NiceCircuits/SUPER_UART/front_panel/SUPER UART 2 front panel.pdf

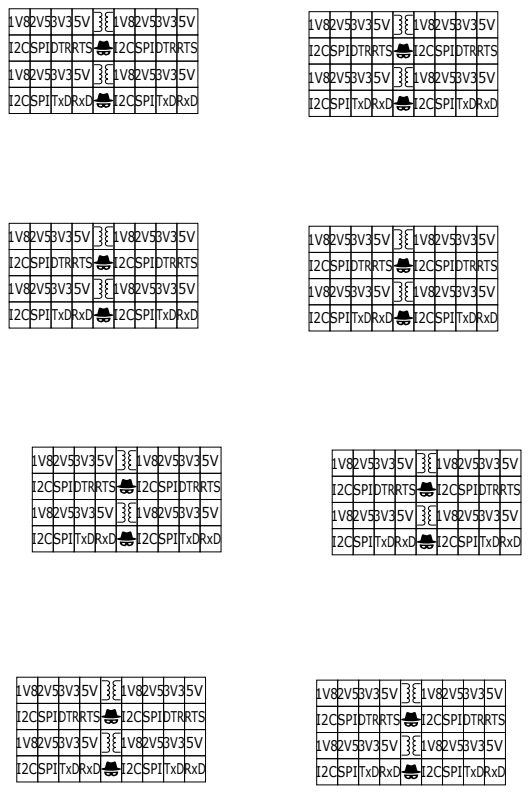
[picture p1: page 1]
1V82V53V35V I2CSPIDTRRTS 1V82V53V35V I2CSPITxDRxD
