NiceCircuits/SUPER_UART/cpld/super_uart.pdf

INV

MPSSE_EN_A | N_MPSSE_EN_A

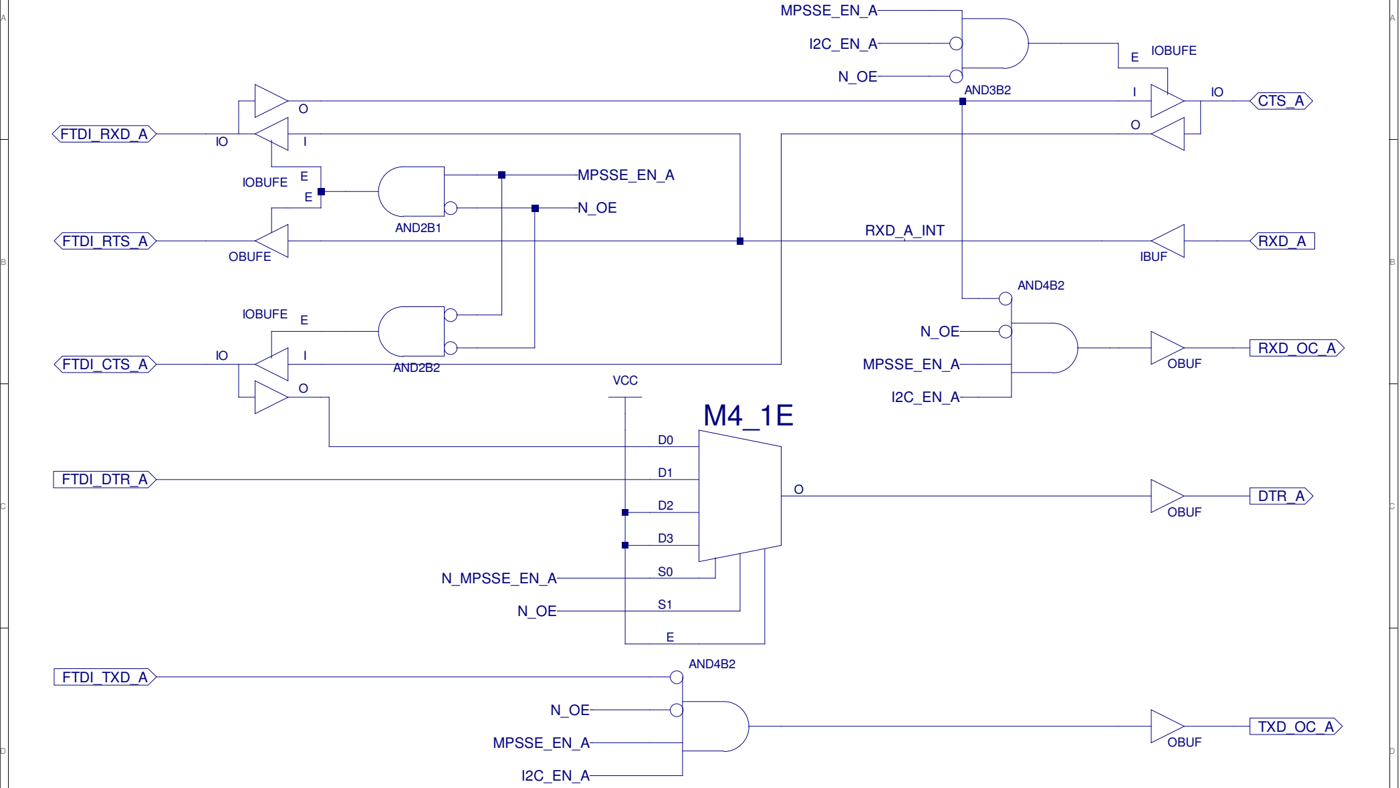
[picture p2: figure]
IOBUFE E; RXD_A_INT; FTDI_RXD_A; AND2B1; MPSSE_EN_A; OBUFE; AND4B2; OBUF; RXD_OC_A; CTS_A; RXD_A; FTDI_DTR_A; FTDI_CTS_A; FTDI_RTS_A; FTDI_TXD_A; TXD_OC_A; N_MPSSE_EN_A; VCC; DTR_A; IBUF; AND3B2; AND2B2

MPSSE_EN_B | N_MPSSE_EN_B
INV

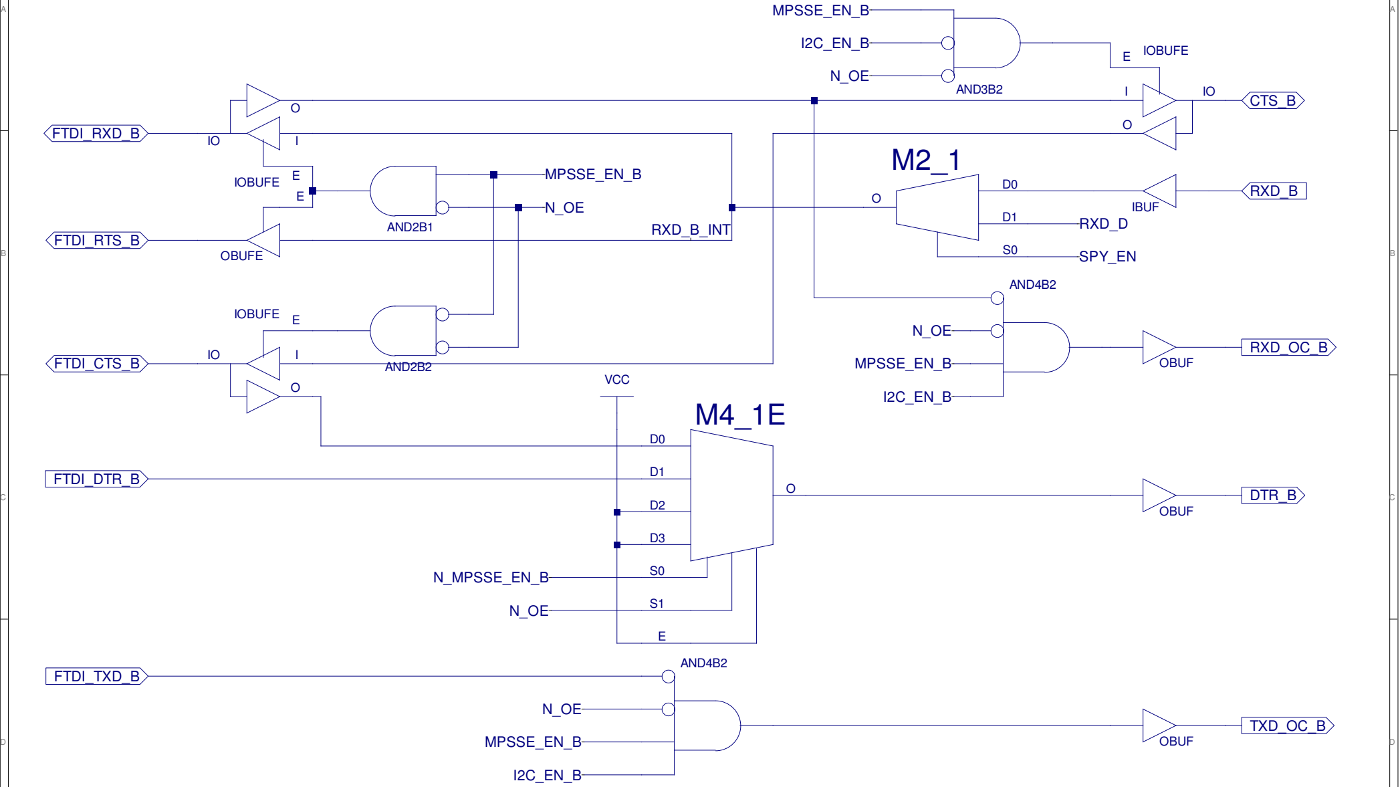
[picture p3: figure]
IOBUFE E; AND2B1; MPSSE_EN_B; OBUFE; AND4B2; OBUF; N_MPSSE_EN_B; VCC; AND3B2; RXD_B_INT; IBUF; RXD_D; SPY_EN; AND2B2; FTDI_RXD_B; RXD_OC_B; CTS_B; FTDI_DTR_B; FTDI_CTS_B; FTDI_RTS_B; FTDI_TXD_B; TXD_OC_B; DTR_B; RXD_B

A | A
B | B

TXD_D_INT

# M4_1E

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
SPY_EN

FTDI_RXD_C
OBUF

N_OE

VCC

RXD_C

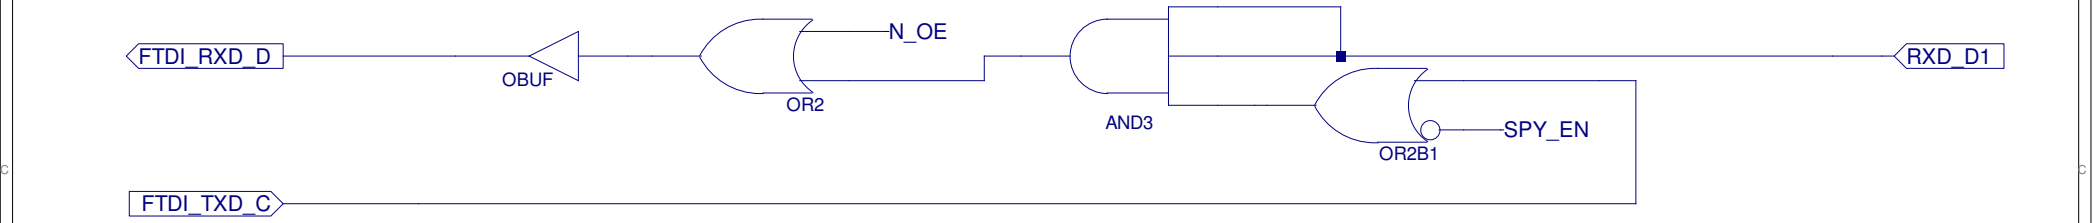
[picture p4: figure]
OBUF; SPY_EN; FTDI_RXD_D; RXD_D1; FTDI_TXD_C; AND3
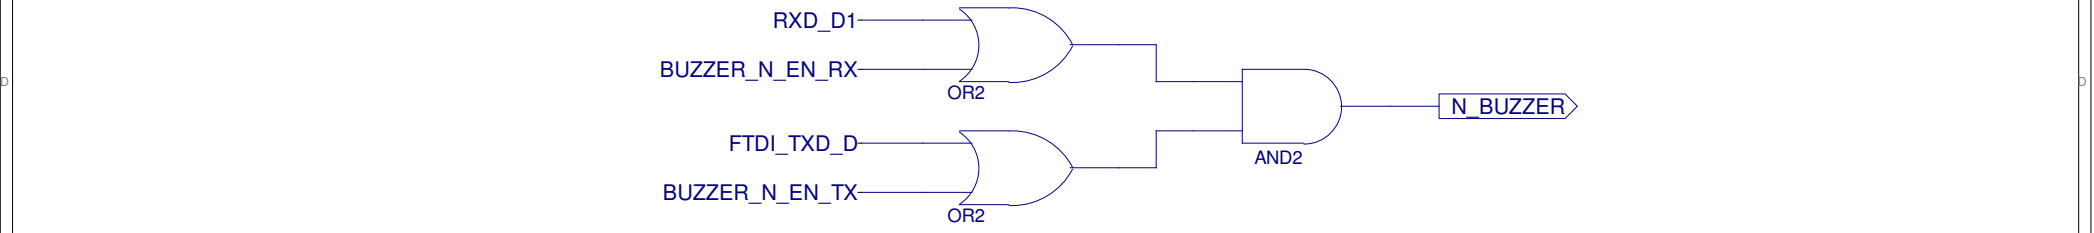
[picture p5: figure]
AND2; BUZZER_N_EN_RX; RXD_D1; FTDI_TXD_D; BUZZER_N_EN_TX; N_BUZZER
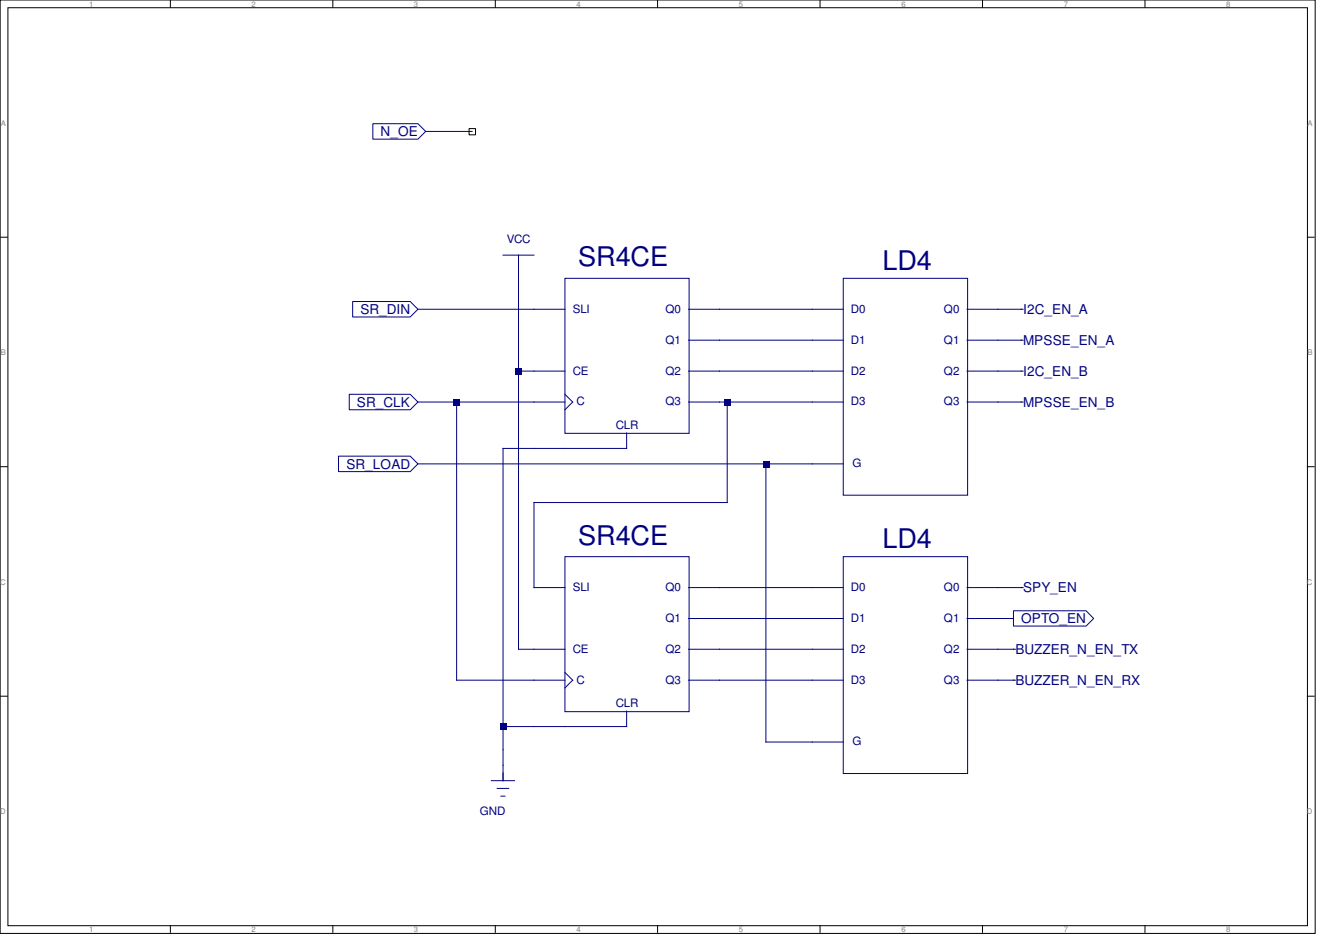
[picture p6: page 4]
