NiceCircuits/SUPER_UART/SUPER_UART_BOM.xlsx

SW | https://www.maritex.com.pl/przelaczniki/przelaczniki_typu_tact_switch/laczniki_tact_switch_5_2x5_2xh_pyloszczelne_smt/tactdf52h16m160-jl.html
93LC46 | farnell
74HC4053D | https://www.maritex.com.pl/polprzewodniki/uklady_logiczne/cmos_serii_74hc/uklady_cmos_serii_74hc_smd/hc4053d.html
FT4232 | alternatywna obudowa? | http://pl.farnell.com/ftdi/ft4232h-56q-reel/interface-bridge-usb-uart-mpsse/dp/2535723
74LVC2T45 | http://pl.farnell.com/nxp/74lvc2t45dc-125/transceiver-bidir-translator-vssop/dp/2444915
 | http://pl.mouser.com/ProductDetail/Nexperia/74LVC2T45DC125/?qs=sGAEpiMZZMutXGli8Ay4kIOzA5y4dyxuGolABzLS2Js%3d
74hc08d | https://www.maritex.com.pl/polprzewodniki/uklady_logiczne/cmos_serii_74hc/uklady_cmos_serii_74hc_smd/hc08d.html
74HC595D | https://www.maritex.com.pl/polprzewodniki/uklady_logiczne/cmos_serii_74hc/uklady_cmos_serii_74hc_smd/hc595d.html
Q 12MHz | https://www.maritex.com.pl/elementy_pasywne/rezonatory_filtry/rezonatory_kwarcowe_smd/rezonatory_kwarcowe_smd_3_2x2_5mm/qsdm12m000-sjk.html
LED R | https://www.maritex.com.pl/led/diody_led_smd/diody_led_0805/diody_led_smd_0805_super-jasne/led0805-s-rw120.html
LED G | https://www.maritex.com.pl/led/diody_led_smd/diody_led_0805/diody_led_smd_0805_super-jasne/led0805-s-gw120.html
inne | https://www.maritex.com.pl/led/diody_led_smd/diody_led_0805/diody_led_smd_0805_super-jasne.html
goldpin | https://www.maritex.com.pl/zlacza/listwy_stykowe_kolkowe/listwy_w_rastrze_2_54mm.html
74LVC8T245PW | Farnell
MIC5504-3.3YM5-TR | Farnell
PDTA143ZT | Farnell
