NiceCircuits/SUPER_UART/doc/SUPER_UART.xlsx

Sheet: Sheet1
 | Pinout
UART | SPI | I2C | FT_UART
RxD |  |  | RxD
TxD | SCK |  | TxD
DTR | MOSI |  | CTS
CTS |  |  | RTS | PINOUT SPI
RTS
 |  |  |  | FTDI PIN | Function | Opto channell | Output pin
 |  |  |  | RxD | MOSI | DTR | RxD
 |  |  |  | TxD | SCK | TxD | TxD
 |  |  |  | CTS | CS | RTS | RTS
 |  |  |  | RTS | MISO | CTS | CTS
 |  |  |  | Pinout I2C
 |  |  |  | FTDI PIN | Function | Opto channell | Output pin
 |  |  |  | RxD | SDA_OUT | DTR | CTS
 |  |  |  | TxD | SCL | TxD | TxD
 |  |  |  | RTS | SDA_IN | CTS | CTS

Sheet: IO
Signal | Port | Direction | Voltage | SPI | Direction | I2C | Direction | SPY 1 | Direction | Direction total | Chip | Additional chip | connection
CTS | A | I | B | MOSI | O | SCL | OC |  |  | I/O/OC | 74LVC1T45 2 | NMOS 3 | CPLD
RxD | A | I | B | MISO | I | SDA | OC |  |  | I/OC | 74LVC1T45 3 | NMOS 4 | CPLD
RxD | C | I | B |  |  |  |  | N.C. | x | I | 74LVC2T45 1 |  | CPLD
CTS | C | I | B |  |  |  |  |  |  | I | 74LVC2T45 1 |  | direct
CTS | B | I | A | MOSI | O | SCL | OC |  |  | I/O/OC | 74LVC1T45 1 | NMOS 1 | CPLD
RxD | B | I | A | MISO | I | SDA | OC | N.C. | x | I/OC | 74LVC8T245 1 | NMOS 2 | CPLD
TxD | B | O | A | SCK | O | N.C. | x | N.C. | x | O | 74LVC8T245 2 |  | CPLD
DTR | B | O | A | CS | O | WP |  |  |  | O | 74LVC8T245 2 |  | direct
DTR | A | O | B | CS | O | WP | O |  |  | O | 74LVC8T245 3 |  | direct
TxD | A | O | B | SCK | O | N.C. | x |  |  | O | 74LVC8T245 3 |  | direct
TxD | C | O | B |  |  |  |  | N.C. | x | O | 74LVC8T245 3 |  | CPLD
DTR | C | O | B |  |  |  |  |  |  | O | 74LVC8T245 3 |  | direct
CTS | D | I | A |  |  |  |  | Master |  | I | 74LVC8T245 1 | RS232 | AND
DCD | D | I | A |  |  |  |  | Master |  | I | 74LVC8T245 1 | RS232 | AND
DSR | D | I | A |  |  |  |  | Master |  | I | 74LVC8T245 1 | RS232 | AND
RI | D | I | A |  |  |  |  | Master |  | I | 74LVC8T245 1 | RS232 | AND
DTR | D | O | A |  |  |  |  | Master |  | O | 74LVC8T245 2 | FORCE | AND
RTS | D | O | A |  |  |  |  | Master |  | O | 74LVC8T245 2 | FORCE | AND
RxD | D | I | A |  |  |  |  | Master |  | I | 74LVC8T245 1 | RS232 | AND, CPLD
TxD | D | O | A |  |  |  |  | Master |  | O | 74LVC8T245 2 | SPY | CPLD
CPLD connections
from FTDI | I2C | to drivers | ext
RxD_D | NMOS 3 | RxD_D | SR_DAT
CTS_A | NMOS 4 | CTS_A | SR_CLK
RxD_A | NMOS 1 | RxD_A | SR_LATCH
CTS_B | NMOS 2 | CTS_B
RxD_B |  | RxD_B
TxD_B
RxD_C |  | RxD_C
TxD_C
TxD_D |  | TxD_D
DTR_D |  | DTR_D
RTS_D |  | RTS_D
RTS_A
RTS_B
TOTAL | 29
MAX | 34
 |  |  | as SR from uC
 |  |  | SPI_EN_A
 |  |  | I2C_EN_A
 |  |  | SPI_EN_B
 |  |  | I2C_EN_B
 |  |  | SPY_EN
 |  |  | DTR_D_FORCE
 |  |  | RTS_D_FORCE

Sheet: Translators
Part | Channels | Direction | Price @10 | Price/ch | Shop
74LV4T125 | 4 | 3.3 -> 1.8..5, separate, OE | 3.34 | 0.835 | only Mouser
74LV1T34 | 1 | 3.3 -> 1.8..5 | 1.11 | 1.11 | Farnell etc.
74LV1T125/126 | 1 | 3.3 -> 1.8..5, OE | 1.11 | 1.11 | Farnell etc.
74LVC1T45 | 1 | * -> *, DIR | 0.76 | 0.76 | TME etc.
74LVC2T45 | 2 | * -> *, DIR | 1.36 | 0.68 | TME etc.
74LVC8T245 | 8 | * -> *, DIR, OE | 3.23 | 0.40375 | TME etc.
74LV1T00/02/04/08/32/86 | 1 | 3.3 -> 1.8..5, logic gate

Sheet: Regulator
Regulated voltage regulator
LP2951CD parameters
Reference Voltage | 1.235 | V
Min. output current | 1 | uA
Feedback Pin Bias Current max. | 40 | nA
Desired output voltages
V1 | 5 | V
V2 | 3.3 | V
V3 | 2.7 | V
V4 | 1.8 | V
Regulator variant 1
R36 for minimum output current | 1.235 | MΩ
R36 selected | 10 | kΩ
R30 calculated | 4.574898785 | kΩ
R30 selected | 4.7 | kΩ
Ifb error max | 0.188 | mV
R35 || R36 calculated | 1.541699867 | kΩ
R35 calculated | 1.822706505 | kΩ
R35 selected | 1.8 | kΩ
R32 || R36 calculated | 2.810895884 | kΩ
R32 calculated | 3.909939039 | kΩ
R32 selected | 3.9 | kΩ
R31 || R36 calculated | 3.962116041 | kΩ
R31 calculated | 6.56209372 | kΩ
R31 selected | 6.8 | kΩ
Output voltages
V1 | 5.040172222 | V
V2 | 3.303783333 | V
V3 | 2.669052941 | V
V4 | 1.81545 | V
Regulator variant 2
Vfb=(Vdd2/R30+Vdd2_sel/Rchain)*(R30||R36||Rchain)
Known points
Vdd2_sel | Vdd2
0 | 5 | V
3.3 | 1.8 | V
R30 selected | 100 | kΩ
Vfb | 1.235 | V
Vfb=5/R30*(R30||R36||Rchain)
Vfb=(1,8/R30+3,3/Rchain)*(R30||R36||Rchain)
(R30||R36||Rchain)=Vfb/5*R30= | 24.7 | kΩ
(1,8/R30+3,3/Rchain)=Vfb/(R30||R36||Rchain)
3,3/Rchain=Vfb/(R30||R36||Rchain)-1,8/R30
Rchain=3,3/(Vfb/(R30||R36||Rchain)-1,8/R30)
Rchain= | 103.125 | kΩ
R36= | 48.10268516 | kΩ
Ifb error max | 4 | mV
R36 selected | 47 | kΩ
R33 selected | 5.6 | kΩ
R34 selected | 47 | kΩ
R31 selected | 47 | kΩ
Rchain total | 99.6 | kΩ
Vdd2/R30+Vdd2_sel/Rchain=Vfb/(R30||R36||Rchain)
Vdd2=(Vfb/(R30||R36||Rchain)-Vdd2_sel/Rchain)*R30
Output voltages
V1 | 5.102619414 | V
V4 | 1.789366402 | V

Sheet: LED
LEDs in project: |  |  | driver resistance
RX/TX buzzer | red | uC | 50
ENABLE A/B/C/D | green | uC | 50
voltage select | green | uC | 50
I2C/SPI/SPY/ISO EN | green | uC | 50
DTR/RTS force | blue | SW | 0
RX/TX | white | 74HC595 | 30
control pins1 | white | 74AC08 | 30
control pins2 | white | 74LVC8T245 | 25
control pins3 | white | FTDI | 15
control pins4 | white | CPLD
LED types | color | intens. @20mA [mcd] | Vdrop @20mA [V] | Vdrop @1mA [V]
HL-PSC-2012U36FC | red | 600 | 2.1 | 1.7
PSC-2012H203BC | blue | 250 | 3.1 | 2.7
HL-PSC-2012U51GC | green | 900 | 3.1 | 2.7
PSC-2012H256W | white | 1200 | 3.1 | 2.7
Desired intensity [mcd] | 35
for white and blue LEDs
 | color | desired current [mA] | desired resistance total | driver resistance | desired resistance | selected
 | blue | 2.80 | 214.2857143 | 0 | 214.2857143 | 220
 | white | 0.58 | 1028.571429 | 30 | 998.5714286 | 1000
for red and green LEDs, multiplexed 1/4
 | color | desired current [mA] | desired resistance total | driver resistance | desired resistance | selected
 | red | 4.67 | 342.8571429 | 50 | 292.8571429 | 220
 | green | 3.11 | 192.8571429 | 50 | 142.8571429 | 220
