NiceCircuits/SUPER_UART/kicad/front/SUPER_UART_Front_Case.stp

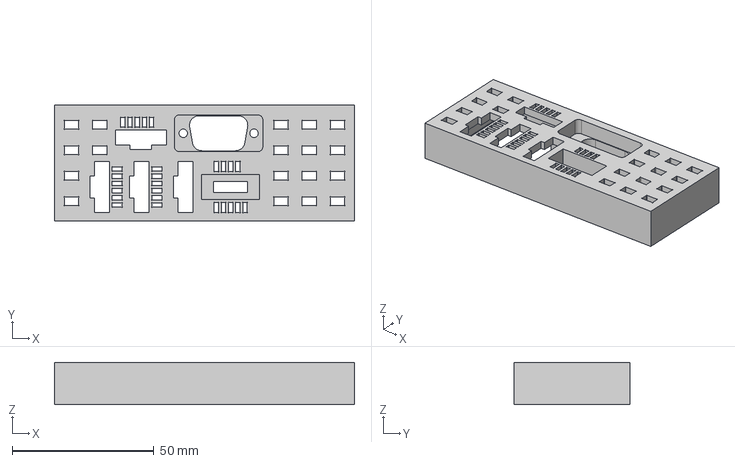
[picture p7: CAD file, 2017-05-09]
kicad/front/SUPER_UART_Front_Case.stp
106.0 x 41.0 x 15.0 mm
