NiceCircuits/SUPER_UART/(list of files, cad)

Other CAD files:
kicad/front/SUPER_UART_Front_Case.dxf
