NiceCircuits/SUPER_UART/kicad/front/SUPER_UART_front.pdf

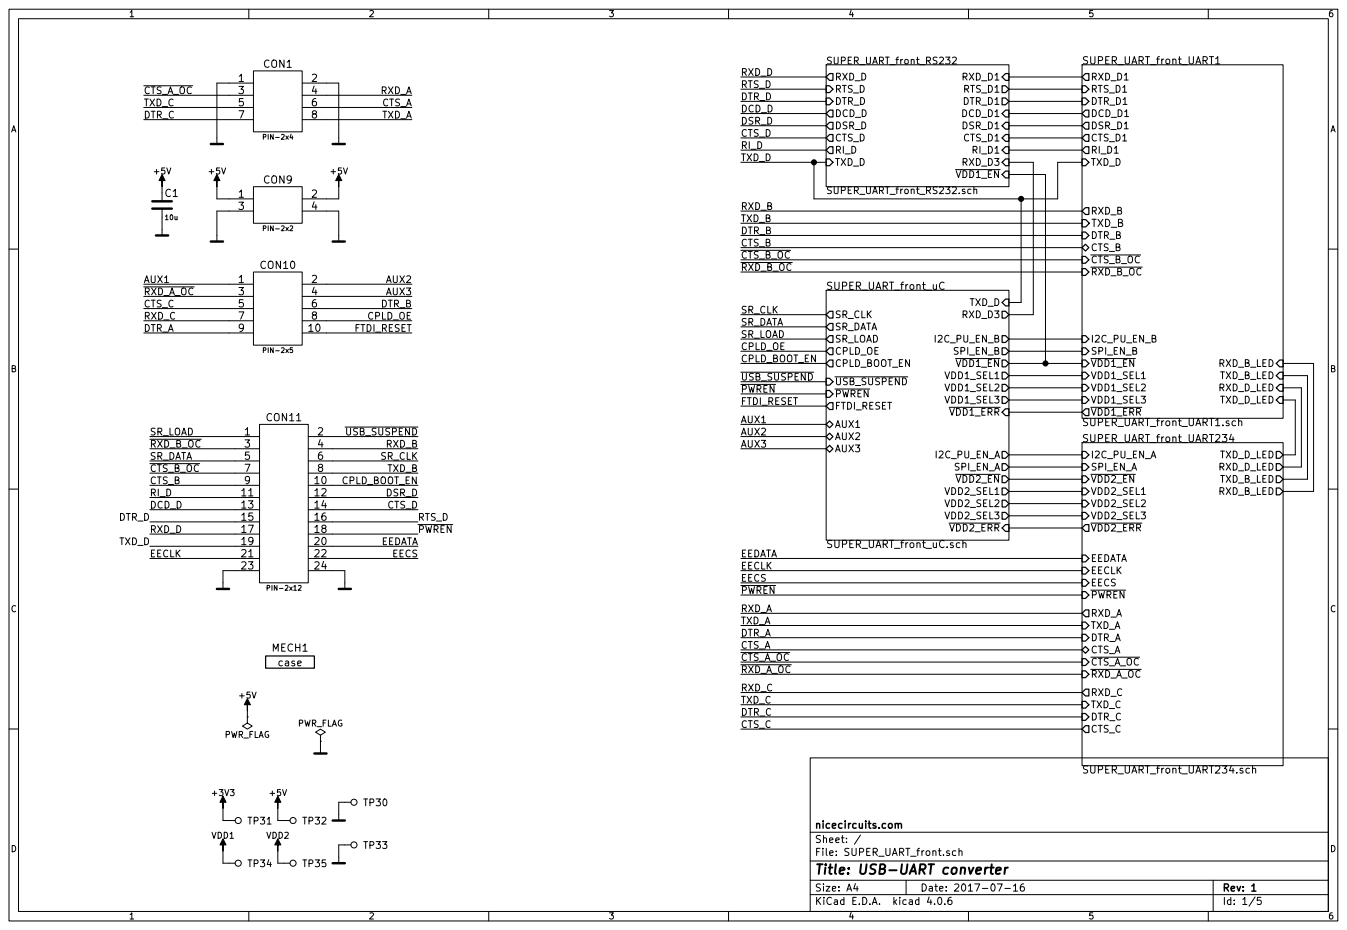
[picture p8: page 1]

CPLD_OE
FTDI_RESET

EECLK | 21 | 22 | EECS

File: SUPER_UART_front.sch Sheet: / nicecircuits.com

Id: 1/5 Title: USB-UART converter

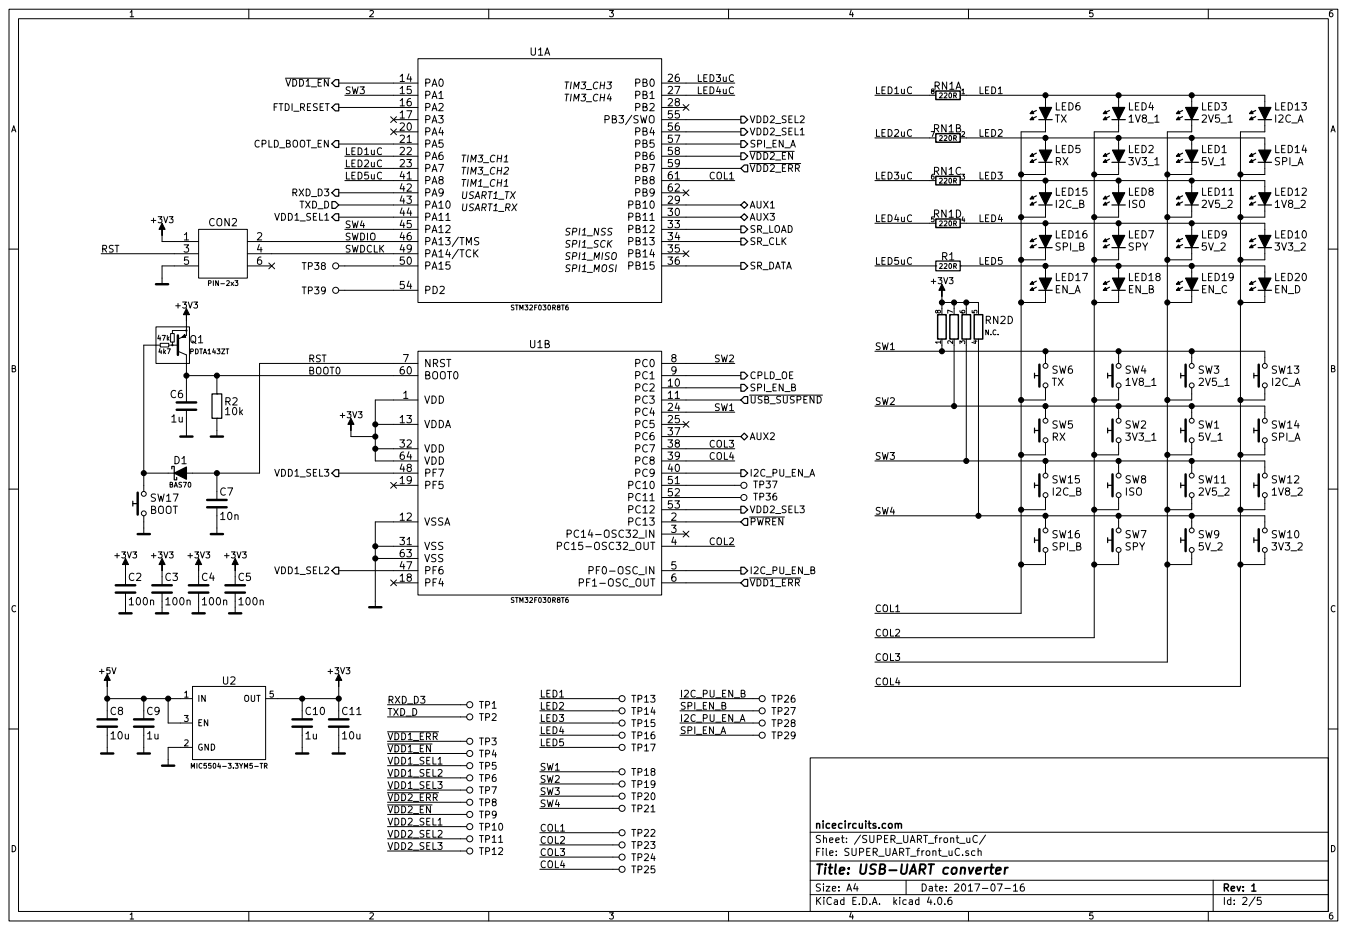
[picture p9: page 2]

File: SUPER_UART_front_uC.sch
Id: 2/5 Title: USB-UART converter

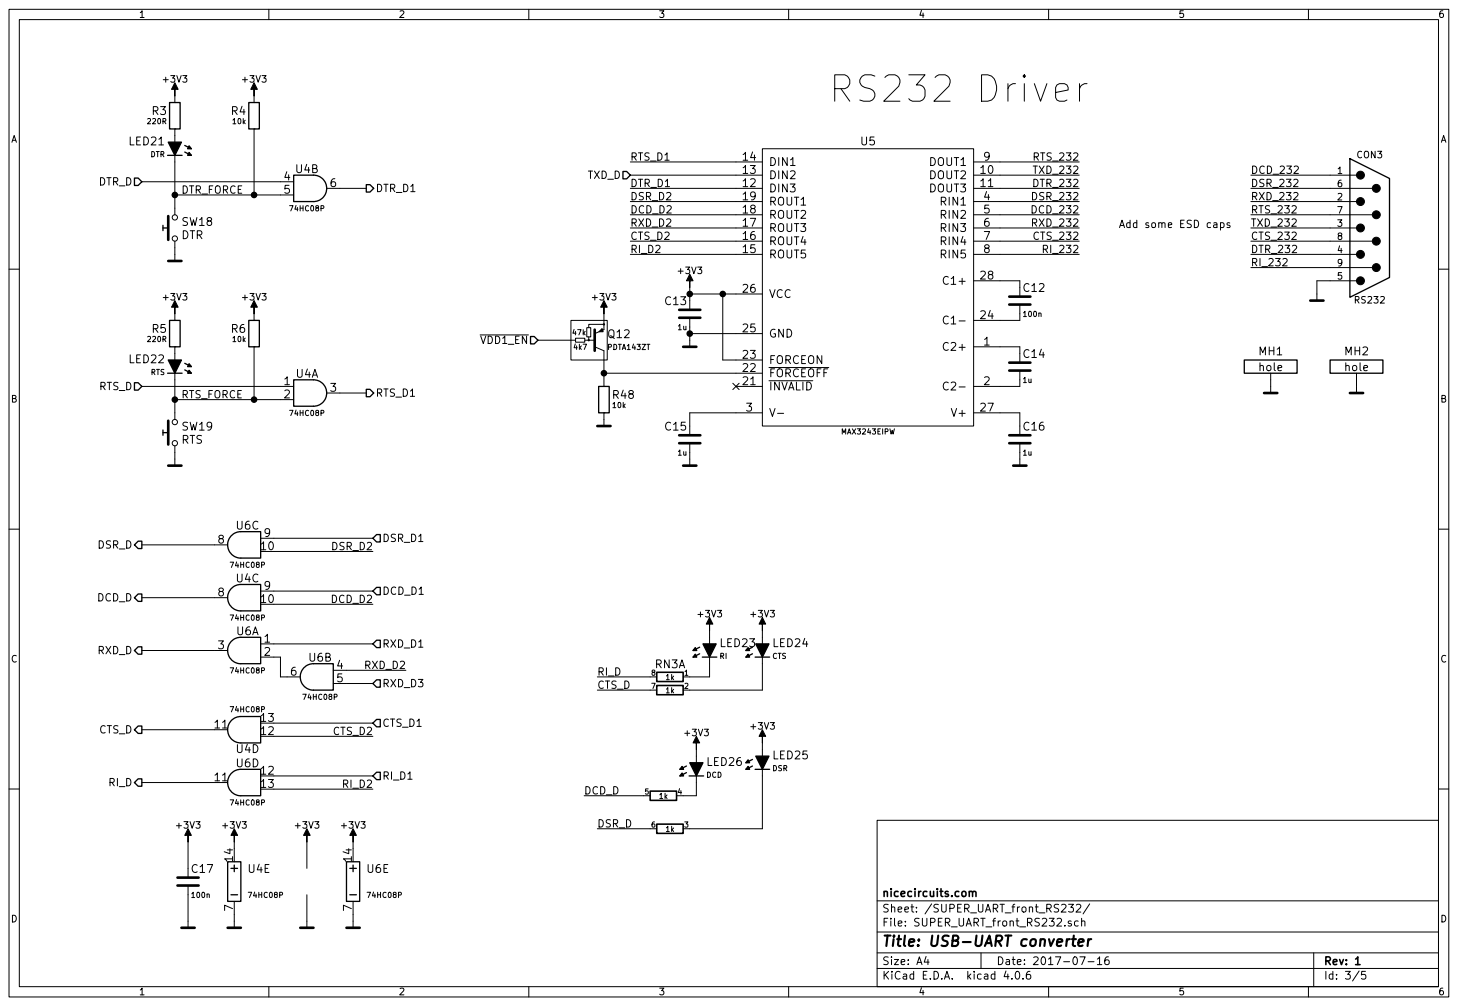
[picture p10: page 3]

Add some ESD caps

File: SUPER_UART_front_RS232.sch
Id: 3/5 Title: USB-UART converter

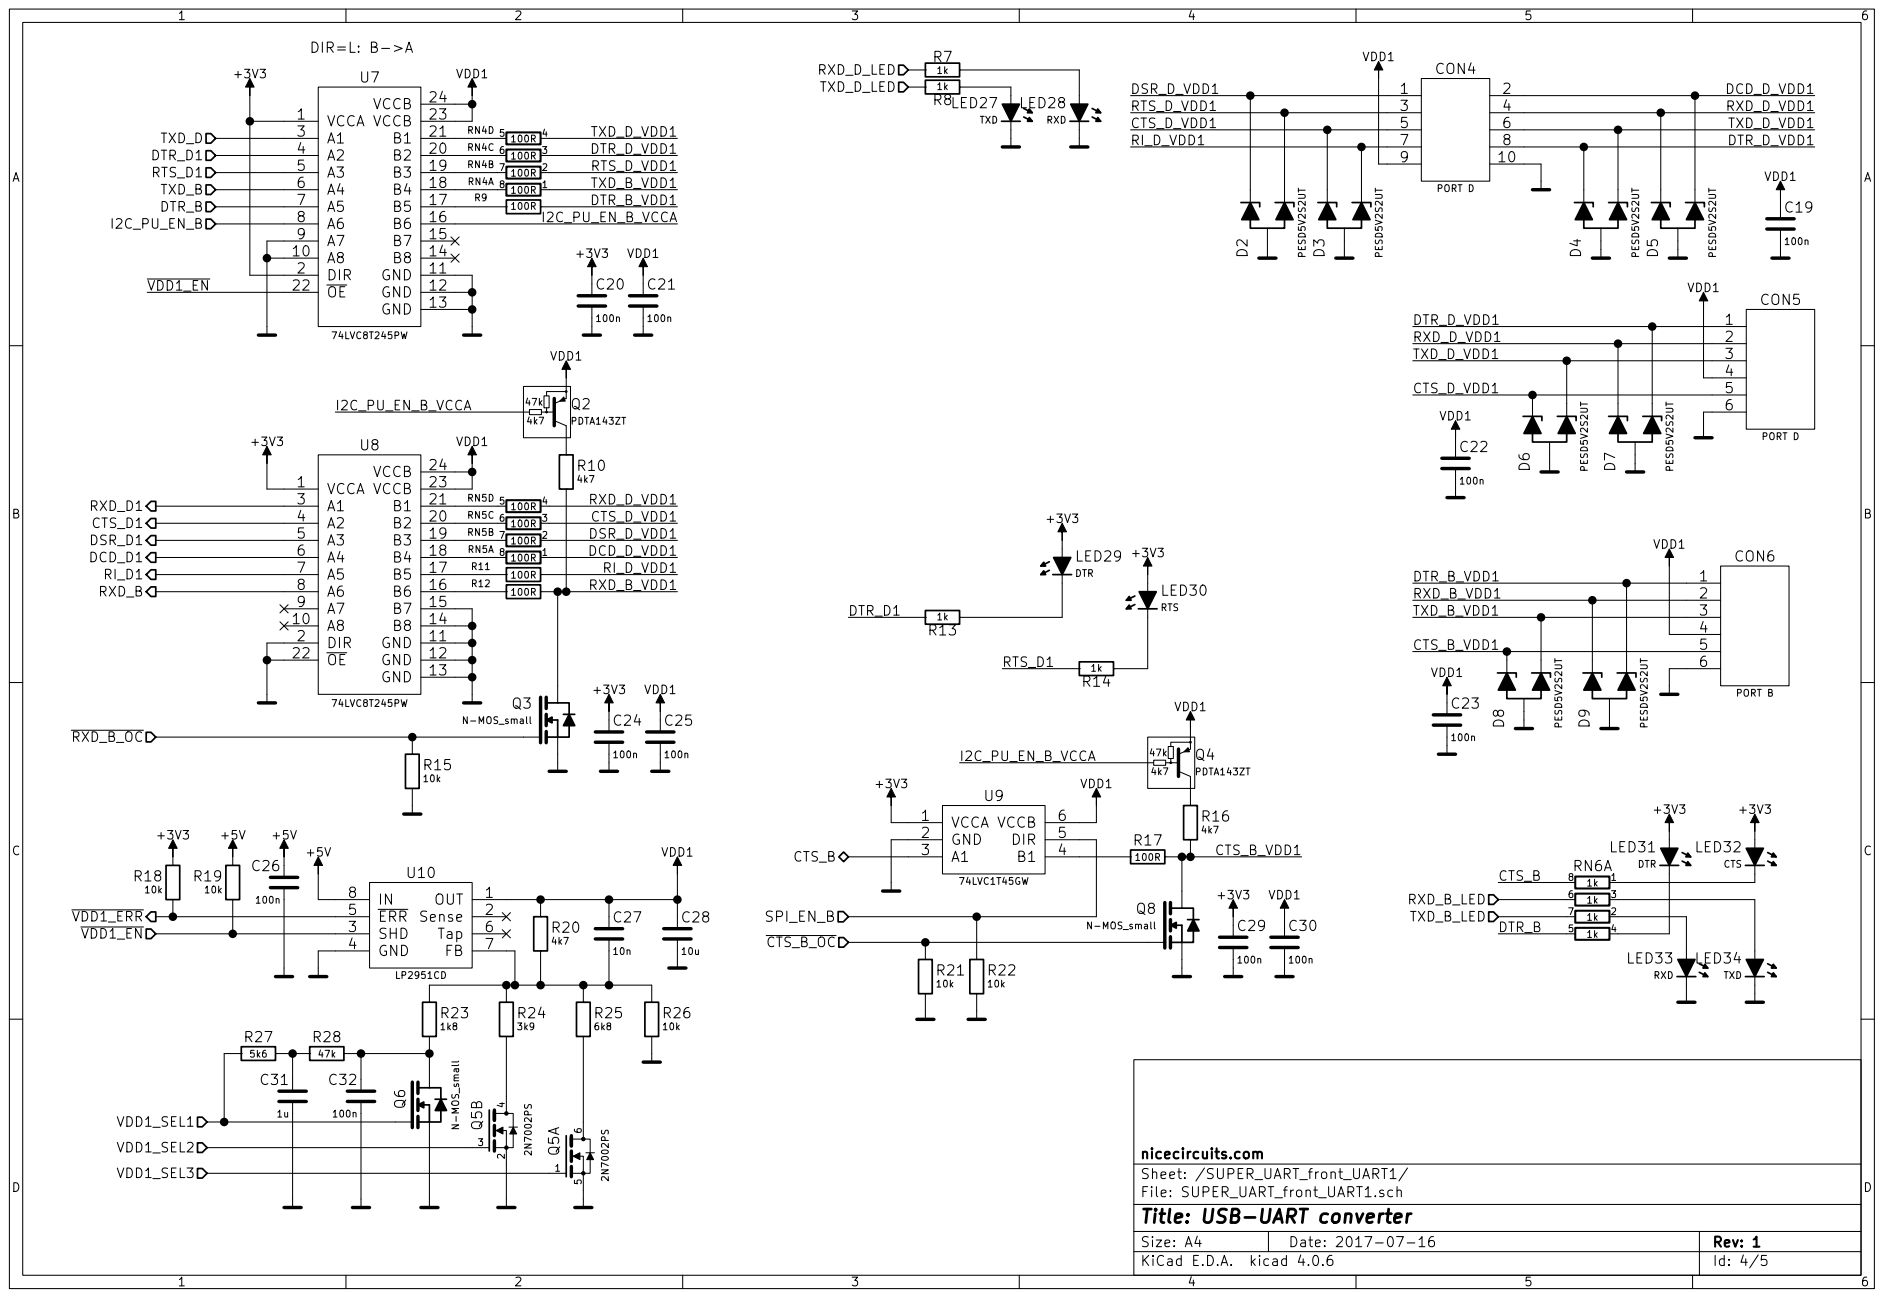
[picture p11: page 4]

TXD_D_VDD1 | 3

TXD_B_VDD1 | 3

File: SUPER_UART_front_UART1.sch
Id: 4/5 Title: USB-UART converter

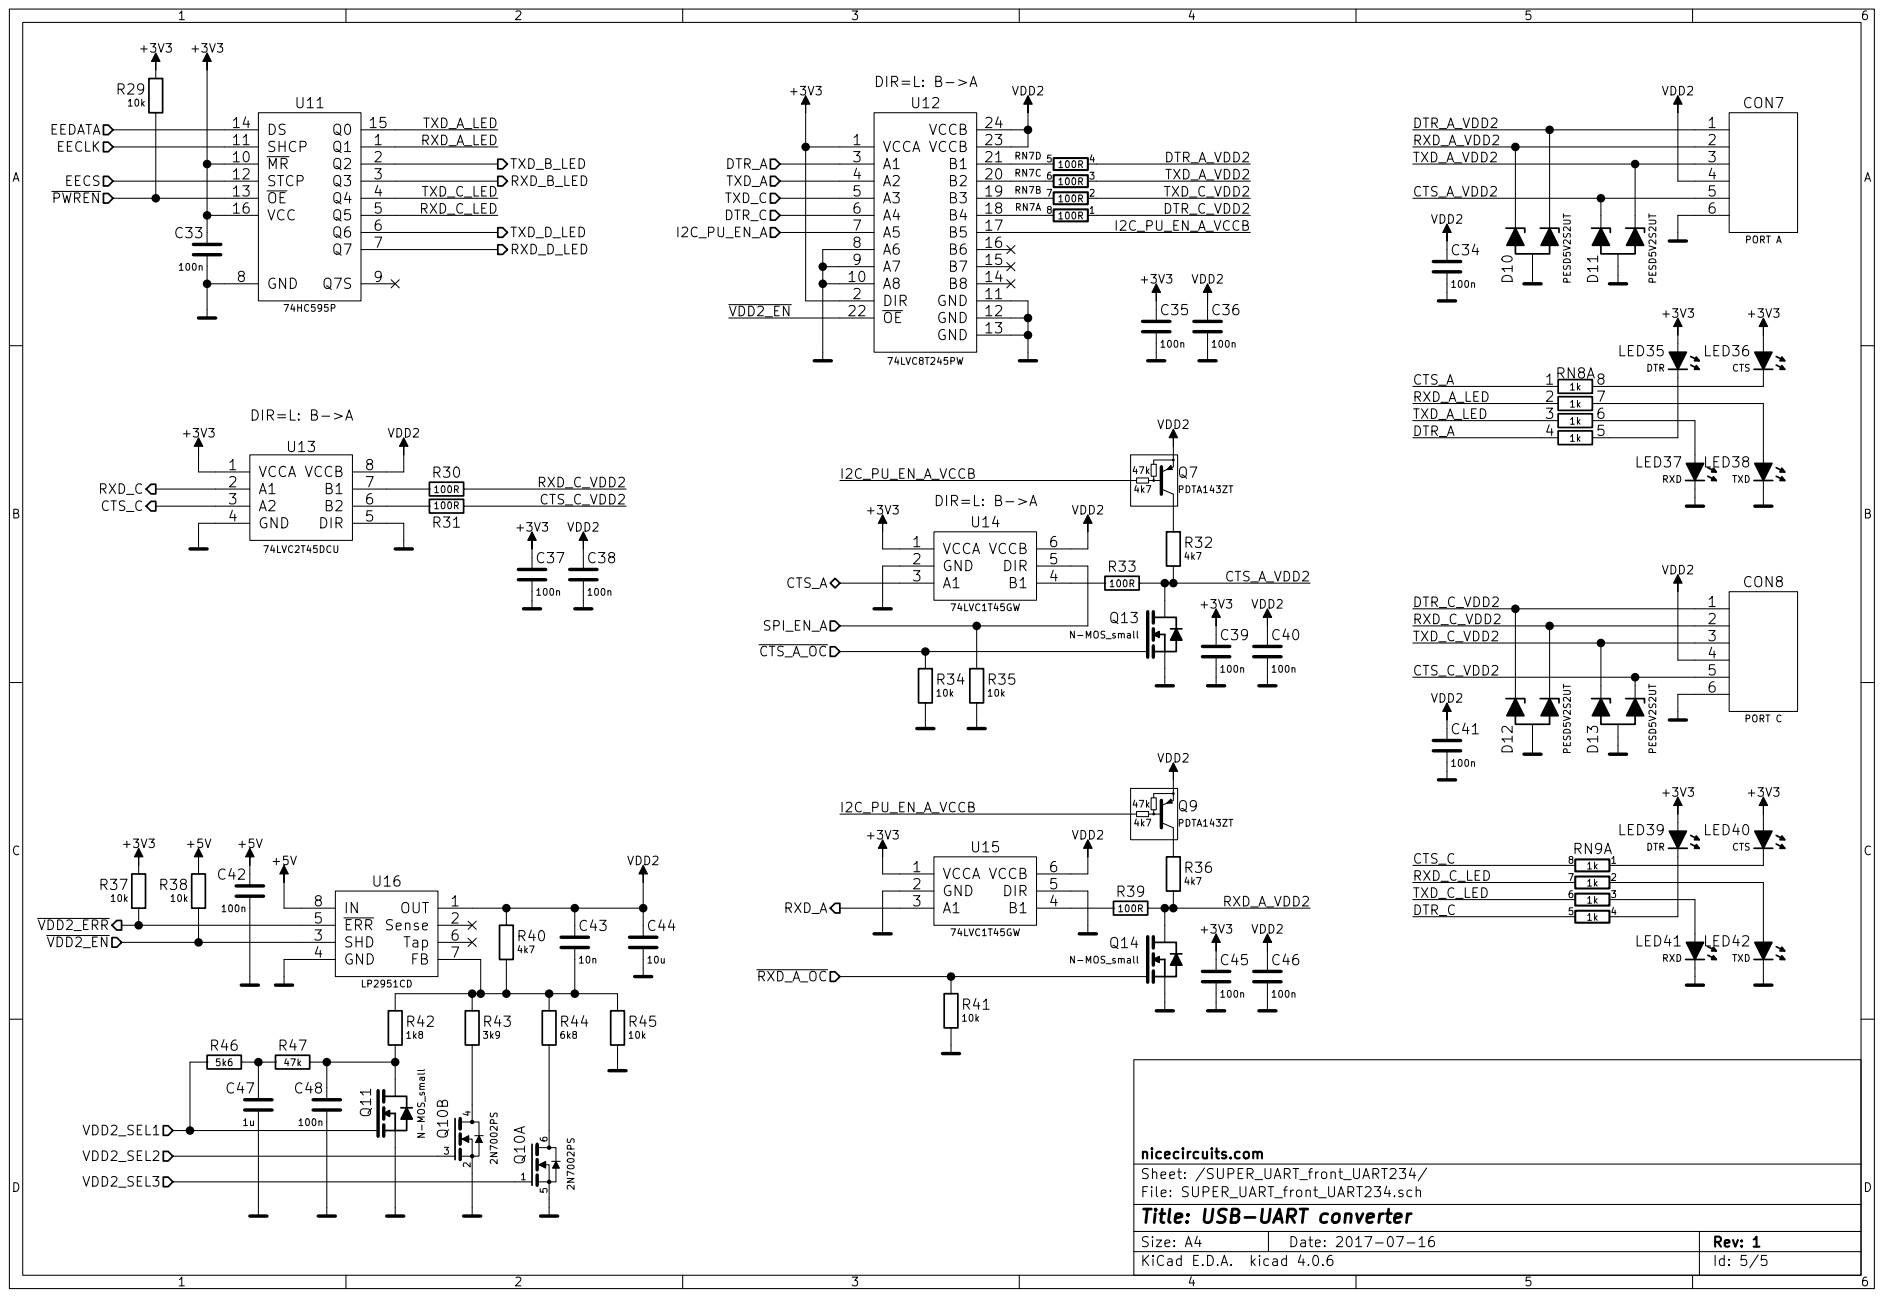
[picture p12: page 5]

TXD_C_VDD2 | 3

File: SUPER_UART_front_UART234.sch
Id: 5/5 Title: USB-UART converter
