NiceCircuits/SUPER_UART/kicad/main/SUPER_UART_main.pdf

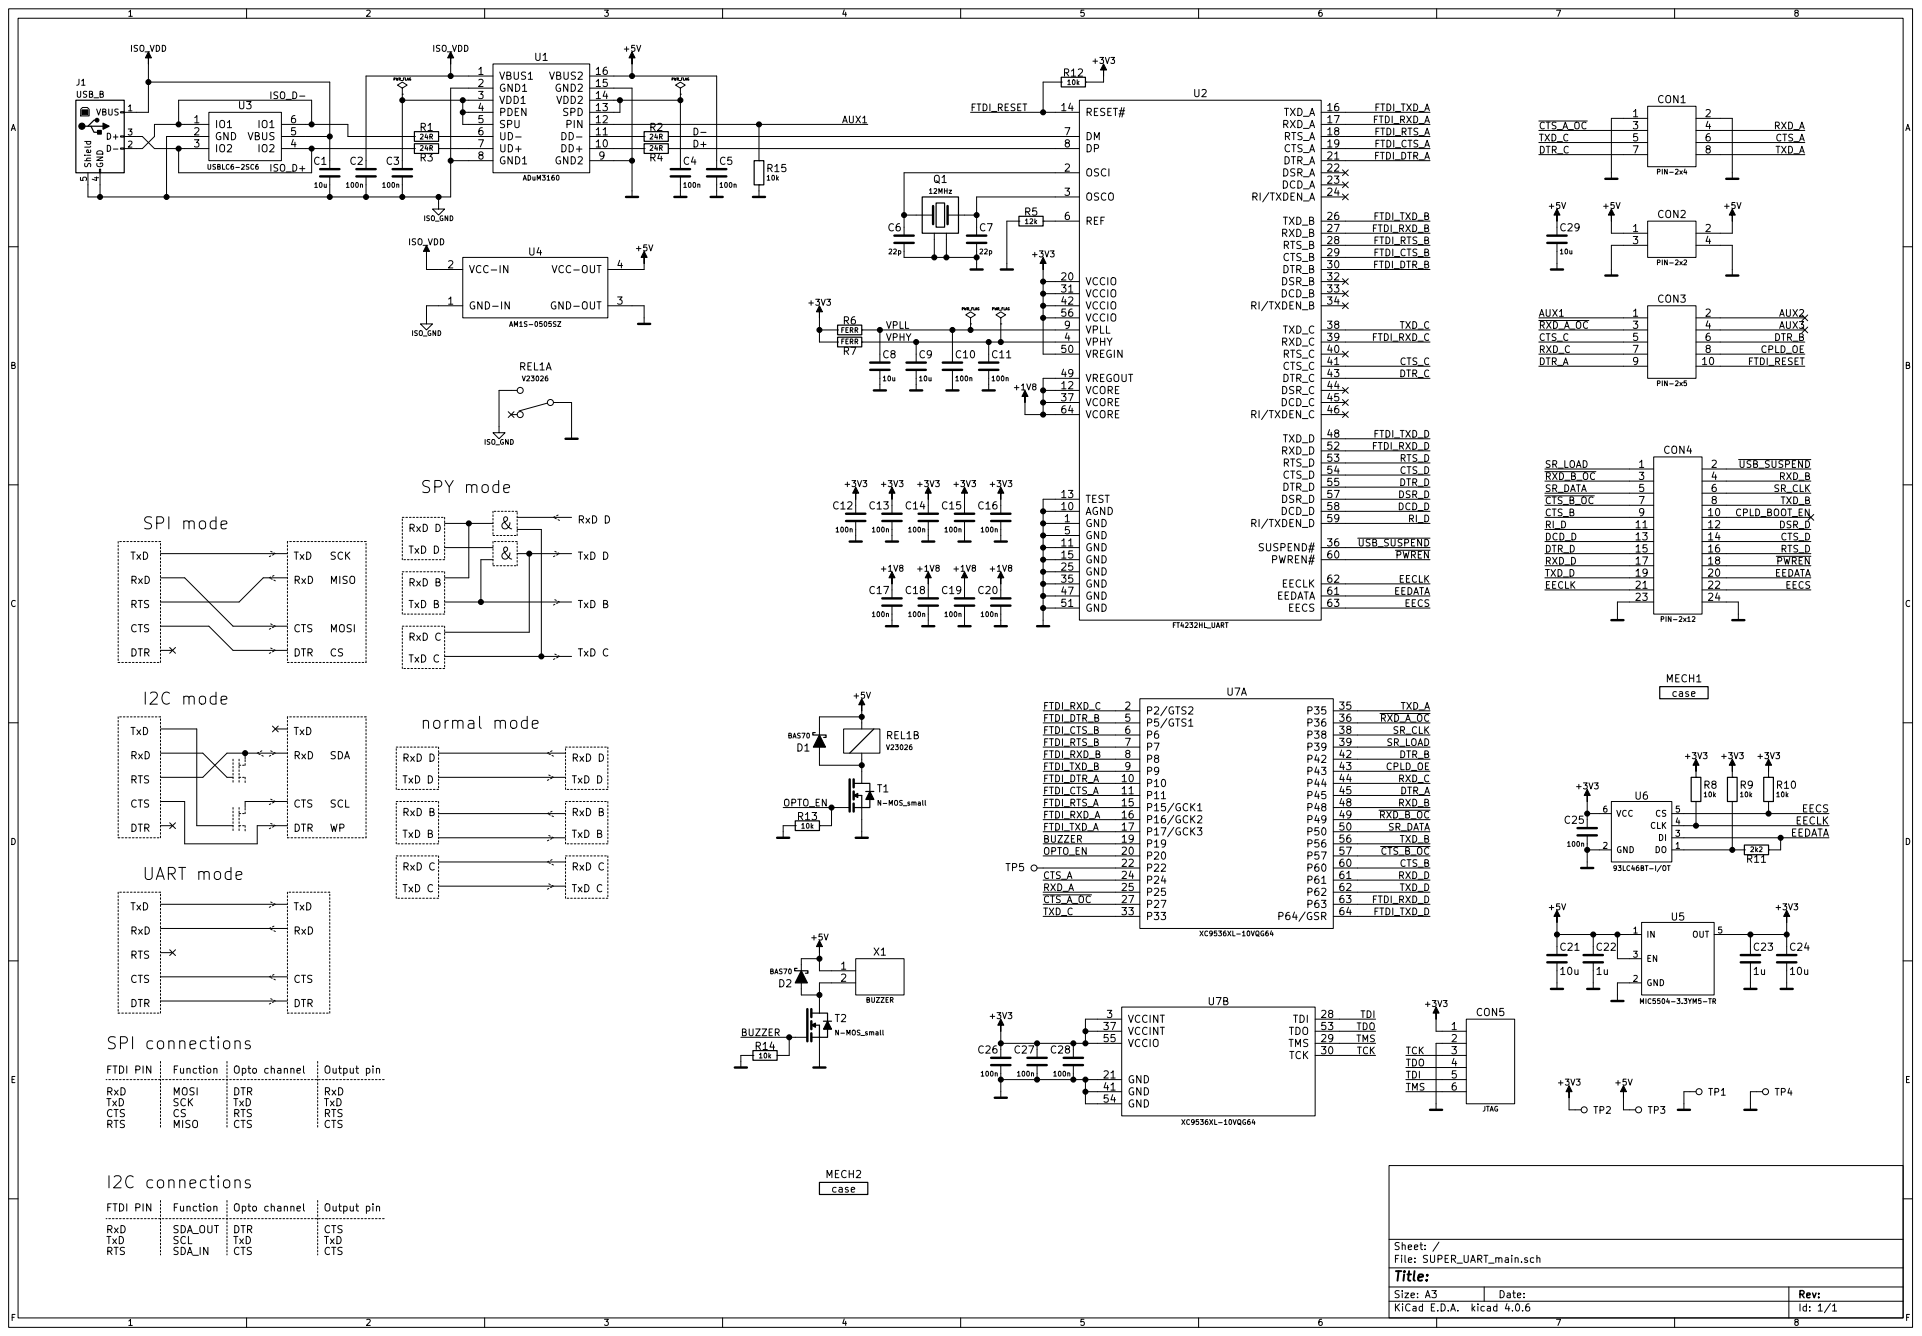
[picture p13: page 1]

FTDI_RTS_B
FTDI_CTS_B

TXD_D | | 20

FTDI_DTR_B

FTDI_TXD_B | CPLD_OE
FTDI_DTR_A
FTDI_CTS_A | DTR_A
FTDI_RTS_A

TDI TDO | 4

TMS
