NiceCircuits/SUPER_UART/img/regulator_northon.asc

R30: res
R30: res
R36: res
R36: res
Rchain: res
Rchain: res
Vdd2/R30: current
Vdd2: voltage
Vdd2_sel/Rchain: current
Vdd2_sel: voltage
Named nets: 0, Vfb
