NiceCircuits/SUPER_UART/sim/LDO.asc

C1: cap; 10µ
C2: cap; 10n
C3: cap; 1µ
C4: cap; 100n
R1: res; 100k
R2: res; 47k
R3: res; 10k
R4: res; 5k6
R5: res; 47k
R6: res; 47k
U1: LP2951
V1: voltage; 5.5
V2: voltage; PULSE(0 3.3 0 1)
Named nets: 0, out, Vin
.tran 2
.meas TRAN duty50 FIND V(Vin)/3.3 WHEN V(out)=5.0
.meas TRAN duty33 FIND V(Vin)/3.3 WHEN V(out)=3.3
.meas TRAN duty25 FIND V(Vin)/3.3 WHEN V(out)=2.5
.meas TRAN duty18 FIND V(Vin)/3.3 WHEN V(out)=1.8
