NiceCircuits/SUPER_UART/sim/STM32_boot_button.asc

C1: cap; 10n
C2: cap; 1µ
D1: schottky; RB521SM-30
M1: nmos; 2N7002
Q1: pnp; BC557B
R1: res; 700k
R2: res; 300k
R3: res; 555k
R4: res; 445k
R5: res; 10k
R6: res; 55k
R7: res; 10k
R8: res; 10k
R9: res; 700k
R10: res; 300k
R11: res; 800k
R12: res; 200k
V1: voltage; 3V3
V2: voltage; 0.07
V3: voltage; 0.398
V4: voltage; PULSE(0 12 100m 1u 1u 100m 100)
V5: voltage; -0.3
V6: voltage; 0.95
X1: comparator; Vhigh=3.3
X2: comparator; Vhigh=3.3
X3: comparator; Vhigh=3.3
X4: comparator; Vhigh=3.3
Named nets: 0, VCC, RST_ACT, RST, RST_NACT, BOOT0, BOOT0_ACT, BOOT0_NACT
.tran 1
