NiceCircuits/SUPER_UART/sim/comparator.asc

B1: bv; V=if(V(IN+)>V(IN-),Vhigh,Vlow)
Named nets: IN+, IN-, OUT+, OUT-
.param Vhigh=1 Vlow=0
