NiceCircuits/SUPER_UART/kicad/front/SUPER_UART_front.kicad_pcb

## KiCad design kicad/front/SUPER_UART_front.kicad_pcb (2020-11-18)

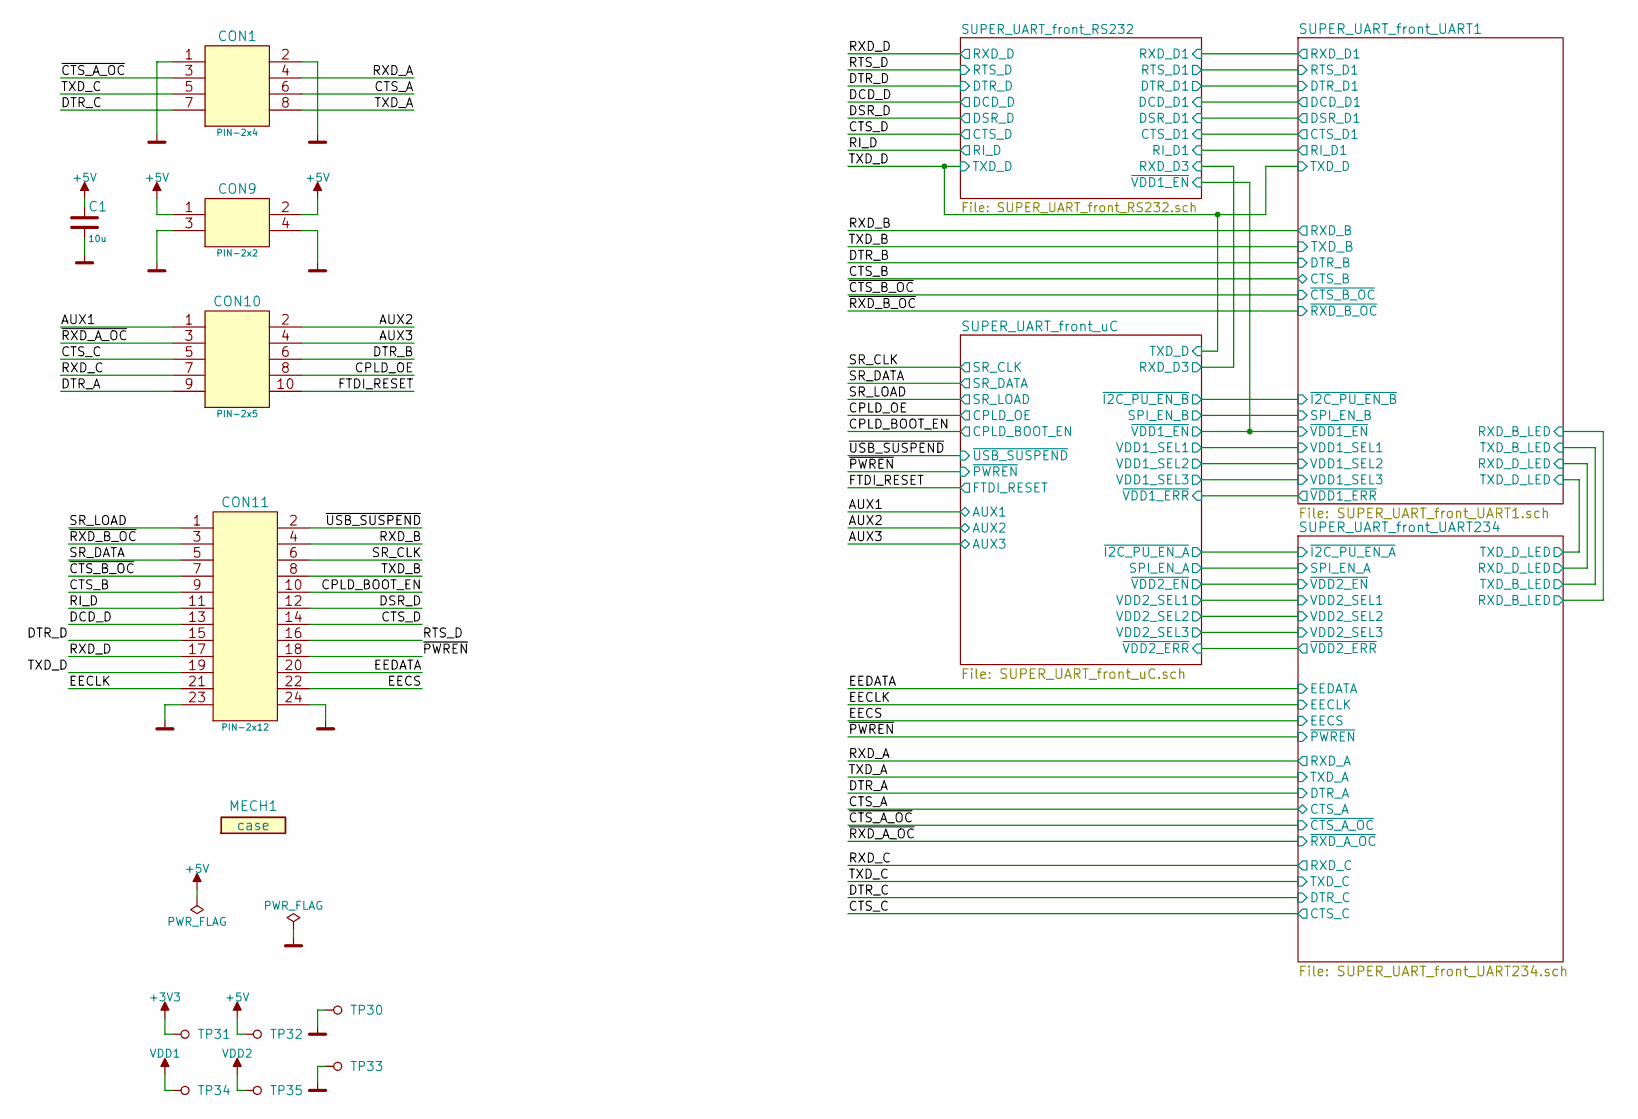
[picture p14: schematic SUPER_UART_front.sch, USB-UART converter]

Parts:
C1: 10u; 0805_N
CON1: PIN-2x4; PIN4x2SMD
CON9: PIN-2x2; PIN2x2SMD
CON10: PIN-2x5; PIN5x2SMD
CON11: PIN-2x12; PIN12x2SMD
MECH1: case; dummy
TP30, TP31, TP32, TP33, TP34, TP35: Testpoint; TP_1mm

Connections:
+3V3: TP31.1; also elsewhere on the board
+5V: C1.1, CON9.1, CON9.2, TP32.1; also elsewhere on the board
/AUX1: CON10.1; also elsewhere on the board
/AUX2: CON10.2; also elsewhere on the board
/AUX3: CON10.4; also elsewhere on the board
/CPLD_BOOT_EN: CON11.10; also elsewhere on the board
/CPLD_OE: CON10.8; also elsewhere on the board
/CTS_A: CON1.6; also elsewhere on the board
/CTS_B: CON11.9; also elsewhere on the board
/CTS_C: CON10.5; also elsewhere on the board
/CTS_D: CON11.14; also elsewhere on the board
/DCD_D: CON11.13; also elsewhere on the board
/DSR_D: CON11.12; also elsewhere on the board
/DTR_A: CON10.9; also elsewhere on the board
/DTR_B: CON10.6; also elsewhere on the board
/DTR_C: CON1.7; also elsewhere on the board
/DTR_D: CON11.15; also elsewhere on the board
/EECLK: CON11.21; also elsewhere on the board
/EECS: CON11.22; also elsewhere on the board
/EEDATA: CON11.20; also elsewhere on the board
/FTDI_RESET: CON10.10; also elsewhere on the board
/RI_D: CON11.11; also elsewhere on the board
/RTS_D: CON11.16; also elsewhere on the board
/RXD_A: CON1.4; also elsewhere on the board
/RXD_B: CON11.4; also elsewhere on the board
/RXD_C: CON10.7; also elsewhere on the board
/RXD_D: CON11.17; also elsewhere on the board
/SR_CLK: CON11.6; also elsewhere on the board
/SR_DATA: CON11.5; also elsewhere on the board
/SR_LOAD: CON11.1; also elsewhere on the board
/TXD_A: CON1.8; also elsewhere on the board
/TXD_B: CON11.8; also elsewhere on the board
/TXD_C: CON1.5; also elsewhere on the board
/TXD_D: CON11.19; also elsewhere on the board
/~CTS_A_OC: CON1.3; also elsewhere on the board
/~CTS_B_OC: CON11.7; also elsewhere on the board
/~PWREN: CON11.18; also elsewhere on the board
/~RXD_A_OC: CON10.3; also elsewhere on the board
/~RXD_B_OC: CON11.3; also elsewhere on the board
/~USB_SUSPEND: CON11.2; also elsewhere on the board
GND: C1.2, CON1.1, CON1.2, CON9.3, CON9.4, CON11.23, CON11.24, TP30.1, TP33.1; also elsewhere on the board
VDD1: TP34.1; also elsewhere on the board
VDD2: TP35.1; also elsewhere on the board

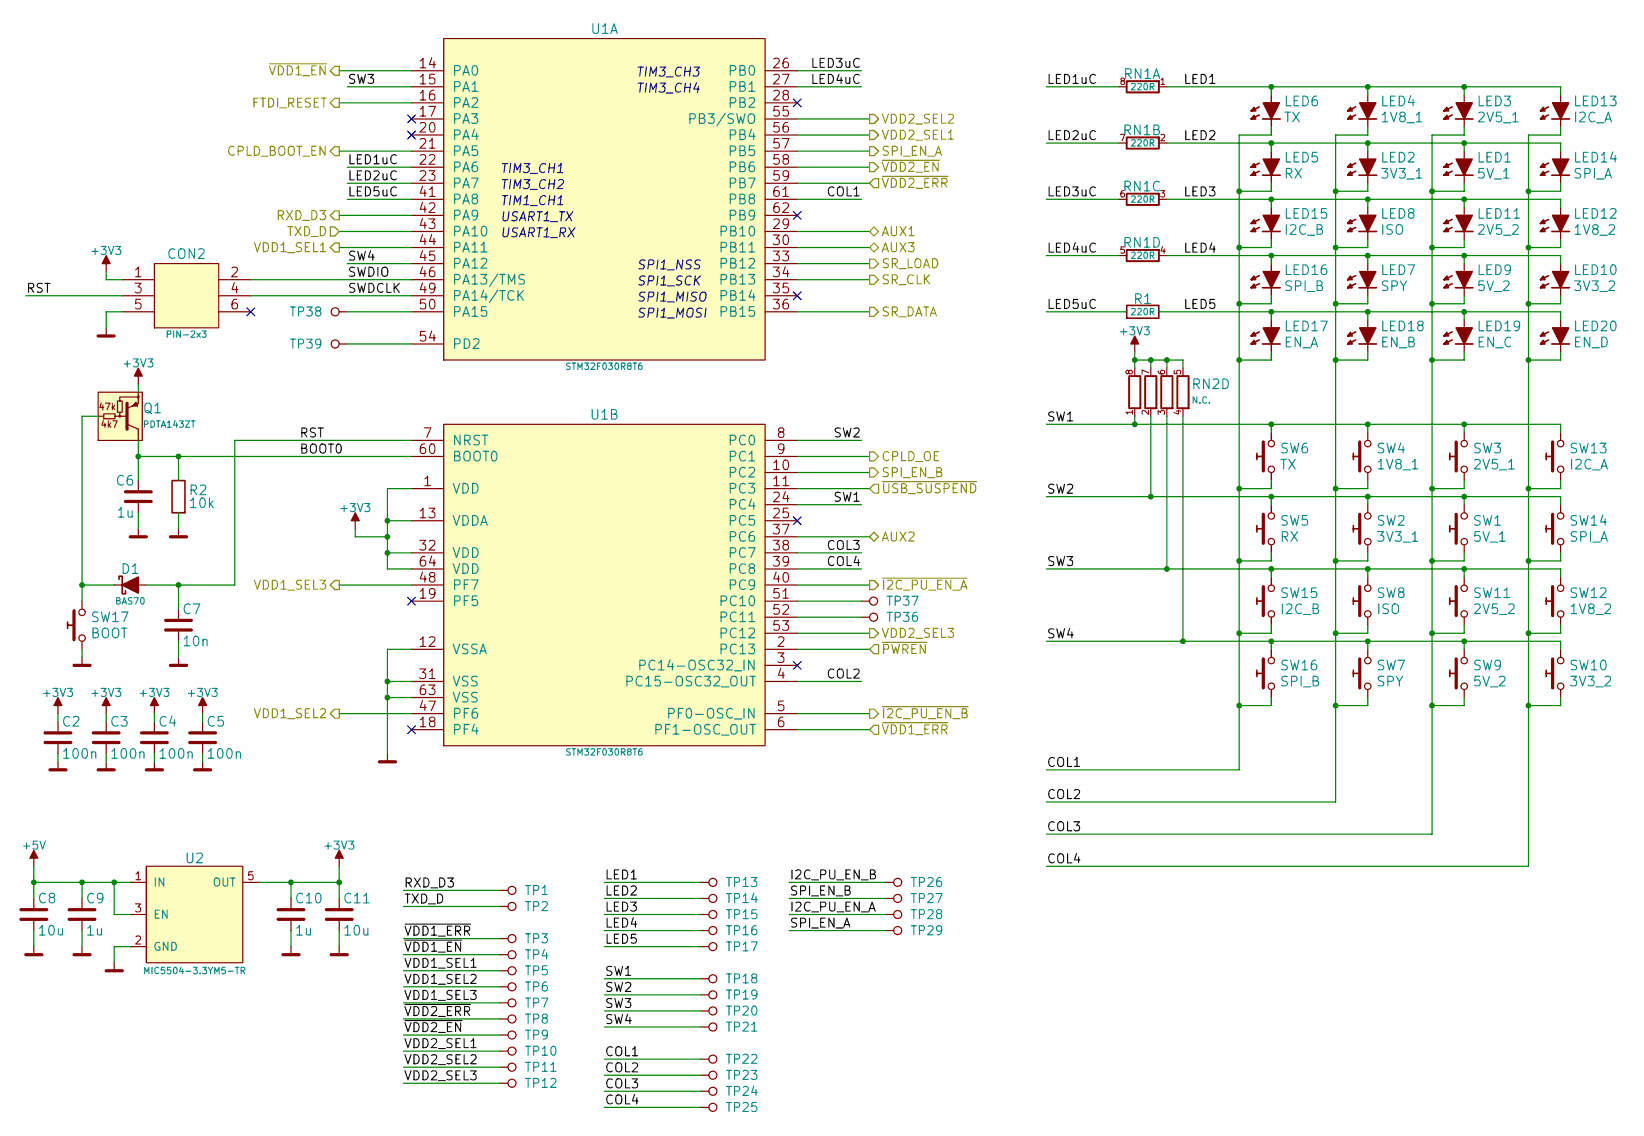
[picture p15: schematic SUPER_UART_front_uC.sch, USB-UART converter]

Parts:
C2, C3, C4, C5: 100n; 0603_N
C6, C9, C10: 1u; 0603_N
C7: 10n; 0603_N
C8, C11: 10u; 0805_N
CON2: PIN-2x3; PIN3x2SMD
D1: BAS70; SOT23-3_N
LED1: 5V_1; 0805D
LED2: 3V3_1; 0805D
LED3: 2V5_1; 0805D
LED4: 1V8_1; 0805D
LED5: RX; 0805D
LED6: TX; 0805D
LED7: SPY; 0805D
LED8: ISO; 0805D
LED9: 5V_2; 0805D
LED10: 3V3_2; 0805D
LED11: 2V5_2; 0805D
LED12: 1V8_2; 0805D
LED13: I2C_A; 0805D
LED14: SPI_A; 0805D
LED15: I2C_B; 0805D
LED16: SPI_B; 0805D
LED17: EN_A; 0805D
LED18: EN_B; 0805D
LED19: EN_C; 0805D
LED20: EN_D; 0805D
Q1: PDTA143ZT; SOT23-3_N
R1: 220R; 0603_R_N
R2: 10k; 0603_R_N
RN1: 220R; 4x0603_N
RN2: N.C.; 4x0603_N
SW1: 5V_1; TACTB-64K-F
SW2: 3V3_1; TACTB-64K-F
SW3: 2V5_1; TACTB-64K-F
SW4: 1V8_1; TACTB-64K-F
SW5: RX; TACTB-64K-F
SW6: TX; TACTB-64K-F
SW7: SPY; TACTB-64K-F
SW8: ISO; TACTB-64K-F
SW9: 5V_2; TACTB-64K-F
SW10: 3V3_2; TACTB-64K-F
SW11: 2V5_2; TACTB-64K-F
SW12: 1V8_2; TACTB-64K-F
SW13: I2C_A; TACTB-64K-F
SW14: SPI_A; TACTB-64K-F
SW15: I2C_B; TACTB-64K-F
SW16: SPI_B; TACTB-64K-F
SW17: BOOT; TACTB-64K-F
TP1, TP2, TP3, TP4, TP5, TP6, TP7, TP8, TP9, TP10, TP11, TP12, TP13, TP14, TP15, TP16, TP17, TP18, TP19, TP20, TP21, TP22, TP23, TP24, TP25, TP26, TP27, TP28, TP29, TP36, TP37, TP38, TP39: Testpoint; TP_1mm
U1: STM32F030R8T6; QFP-64-0.5_N
U2: MIC5504-3.3YM5-TR; SOT23-5_N

Connections:
+3V3: C2.1, C3.1, C4.1, C5.1, C10.1, C11.1, CON2.1, Q1.2 (E), RN2.5, RN2.6, RN2.7, RN2.8, U1.1 (VDD), U1.13 (VDDA), U1.32 (VDD), U1.64 (VDD), U2.5 (OUT); also elsewhere on the board
+5V: C8.1, C9.1, U2.1 (IN), U2.3 (EN); also elsewhere on the board
/AUX1: U1.29 (PB10); also elsewhere on the board
/AUX2: U1.37 (PC6); also elsewhere on the board
/AUX3: U1.30 (PB11); also elsewhere on the board
/CPLD_BOOT_EN: U1.21 (PA5); also elsewhere on the board
/CPLD_OE: U1.9 (PC1); also elsewhere on the board
/FTDI_RESET: U1.16 (PA2); also elsewhere on the board
/SR_CLK: U1.34 (PB13); also elsewhere on the board
/SR_DATA: U1.36 (PB15); also elsewhere on the board
/SR_LOAD: U1.33 (PB12); also elsewhere on the board
/SUPER_UART_front_RS232/RXD_D3: TP1.1, U1.42 (PA9); also elsewhere on the board
/SUPER_UART_front_RS232/~VDD1_EN: TP4.1, U1.14 (PA0); also elsewhere on the board
/SUPER_UART_front_UART1/I2C_PU_EN_B: TP26.1, U1.5 (PF0-OSC_IN); also elsewhere on the board
/SUPER_UART_front_UART1/SPI_EN_B: TP27.1, U1.10 (PC2); also elsewhere on the board
/SUPER_UART_front_UART1/VDD1_SEL1: TP5.1, U1.44 (PA11); also elsewhere on the board
/SUPER_UART_front_UART1/VDD1_SEL2: TP6.1, U1.47 (PF6); also elsewhere on the board
/SUPER_UART_front_UART1/VDD1_SEL3: TP7.1, U1.48 (PF7); also elsewhere on the board
/SUPER_UART_front_UART1/~VDD1_ERR: TP3.1, U1.6 (PF1-OSC_OUT); also elsewhere on the board
/SUPER_UART_front_UART234/I2C_PU_EN_A: TP28.1, U1.40 (PC9); also elsewhere on the board
/SUPER_UART_front_UART234/SPI_EN_A: TP29.1, U1.57 (PB5); also elsewhere on the board
/SUPER_UART_front_UART234/VDD2_SEL1: TP10.1, U1.56 (PB4); also elsewhere on the board
/SUPER_UART_front_UART234/VDD2_SEL2: TP11.1, U1.55 (PB3/SWO); also elsewhere on the board
/SUPER_UART_front_UART234/VDD2_SEL3: TP12.1, U1.53 (PC12); also elsewhere on the board
/SUPER_UART_front_UART234/~VDD2_EN: TP9.1, U1.58 (PB6); also elsewhere on the board
/SUPER_UART_front_UART234/~VDD2_ERR: TP8.1, U1.59 (PB7); also elsewhere on the board
/SUPER_UART_front_uC/BOOT0: C6.1, Q1.3 (C), R2.2, U1.60 (BOOT0)
/SUPER_UART_front_uC/COL1: LED5.1 (A), LED6.1 (A), LED15.1 (A), LED16.1 (A), LED17.1 (A), SW5.2, SW6.2, SW15.2, SW16.2, TP22.1, U1.61 (PB8)
/SUPER_UART_front_uC/COL2: LED2.1 (A), LED4.1 (A), LED7.1 (A), LED8.1 (A), LED18.1 (A), SW2.2, SW4.2, SW7.2, SW8.2, TP23.1, U1.4 (PC15-OSC32_OUT)
/SUPER_UART_front_uC/COL3: LED1.1 (A), LED3.1 (A), LED9.1 (A), LED11.1 (A), LED19.1 (A), SW1.2, SW3.2, SW9.2, SW11.2, TP24.1, U1.38 (PC7)
/SUPER_UART_front_uC/COL4: LED10.1 (A), LED12.1 (A), LED13.1 (A), LED14.1 (A), LED20.1 (A), SW10.2, SW12.2, SW13.2, SW14.2, TP25.1, U1.39 (PC8)
/SUPER_UART_front_uC/LED1: LED3.2 (C), LED4.2 (C), LED6.2 (C), LED13.2 (C), RN1.1, TP13.1
/SUPER_UART_front_uC/LED1uC: RN1.8, U1.22 (PA6)
/SUPER_UART_front_uC/LED2: LED1.2 (C), LED2.2 (C), LED5.2 (C), LED14.2 (C), RN1.2, TP14.1
/SUPER_UART_front_uC/LED2uC: RN1.7, U1.23 (PA7)
/SUPER_UART_front_uC/LED3: LED8.2 (C), LED11.2 (C), LED12.2 (C), LED15.2 (C), RN1.3, TP15.1
/SUPER_UART_front_uC/LED3uC: RN1.6, U1.26 (PB0)
/SUPER_UART_front_uC/LED4: LED7.2 (C), LED9.2 (C), LED10.2 (C), LED16.2 (C), RN1.4, TP16.1
/SUPER_UART_front_uC/LED4uC: RN1.5, U1.27 (PB1)
/SUPER_UART_front_uC/LED5: LED17.2 (C), LED18.2 (C), LED19.2 (C), LED20.2 (C), R1.2, TP17.1
/SUPER_UART_front_uC/LED5uC: R1.1, U1.41 (PA8)
/SUPER_UART_front_uC/RST: C7.1, CON2.3, D1.1 (C), U1.7 (NRST)
/SUPER_UART_front_uC/SW1: RN2.1, SW3.1, SW4.1, SW6.1, SW13.1, TP18.1, U1.24 (PC4)
/SUPER_UART_front_uC/SW2: RN2.2, SW1.1, SW2.1, SW5.1, SW14.1, TP19.1, U1.8 (PC0)
/SUPER_UART_front_uC/SW3: RN2.3, SW8.1, SW11.1, SW12.1, SW15.1, TP20.1, U1.15 (PA1)
/SUPER_UART_front_uC/SW4: RN2.4, SW7.1, SW9.1, SW10.1, SW16.1, TP21.1, U1.45 (PA12)
/SUPER_UART_front_uC/SWDCLK: CON2.4, U1.49 (PA14/TCK)
/SUPER_UART_front_uC/SWDIO: CON2.2, U1.46 (PA13/TMS)
/TXD_D: TP2.1, U1.43 (PA10); also elsewhere on the board
/~PWREN: U1.2 (PC13); also elsewhere on the board
/~USB_SUSPEND: U1.11 (PC3); also elsewhere on the board
GND: C2.2, C3.2, C4.2, C5.2, C6.2, C7.2, C8.2, C9.2, C10.2, C11.2, CON2.5, R2.1, SW17.2, U1.12 (VSSA), U1.31 (VSS), U1.63 (VSS), U2.2 (GND); also elsewhere on the board
unnamed: D1.3 (A), Q1.1 (B), SW17.1
unnamed: TP36.1, U1.52 (PC11)
unnamed: TP37.1, U1.51 (PC10)
unnamed: TP38.1, U1.50 (PA15)
unnamed: TP39.1, U1.54 (PD2)

Notes on the sheet:
USART1_TX
USART1_RX
TIM3_CH1
TIM3_CH2
TIM1_CH1
TIM3_CH3
TIM3_CH4
SPI1_NSS
SPI1_SCK
SPI1_MISO
SPI1_MOSI

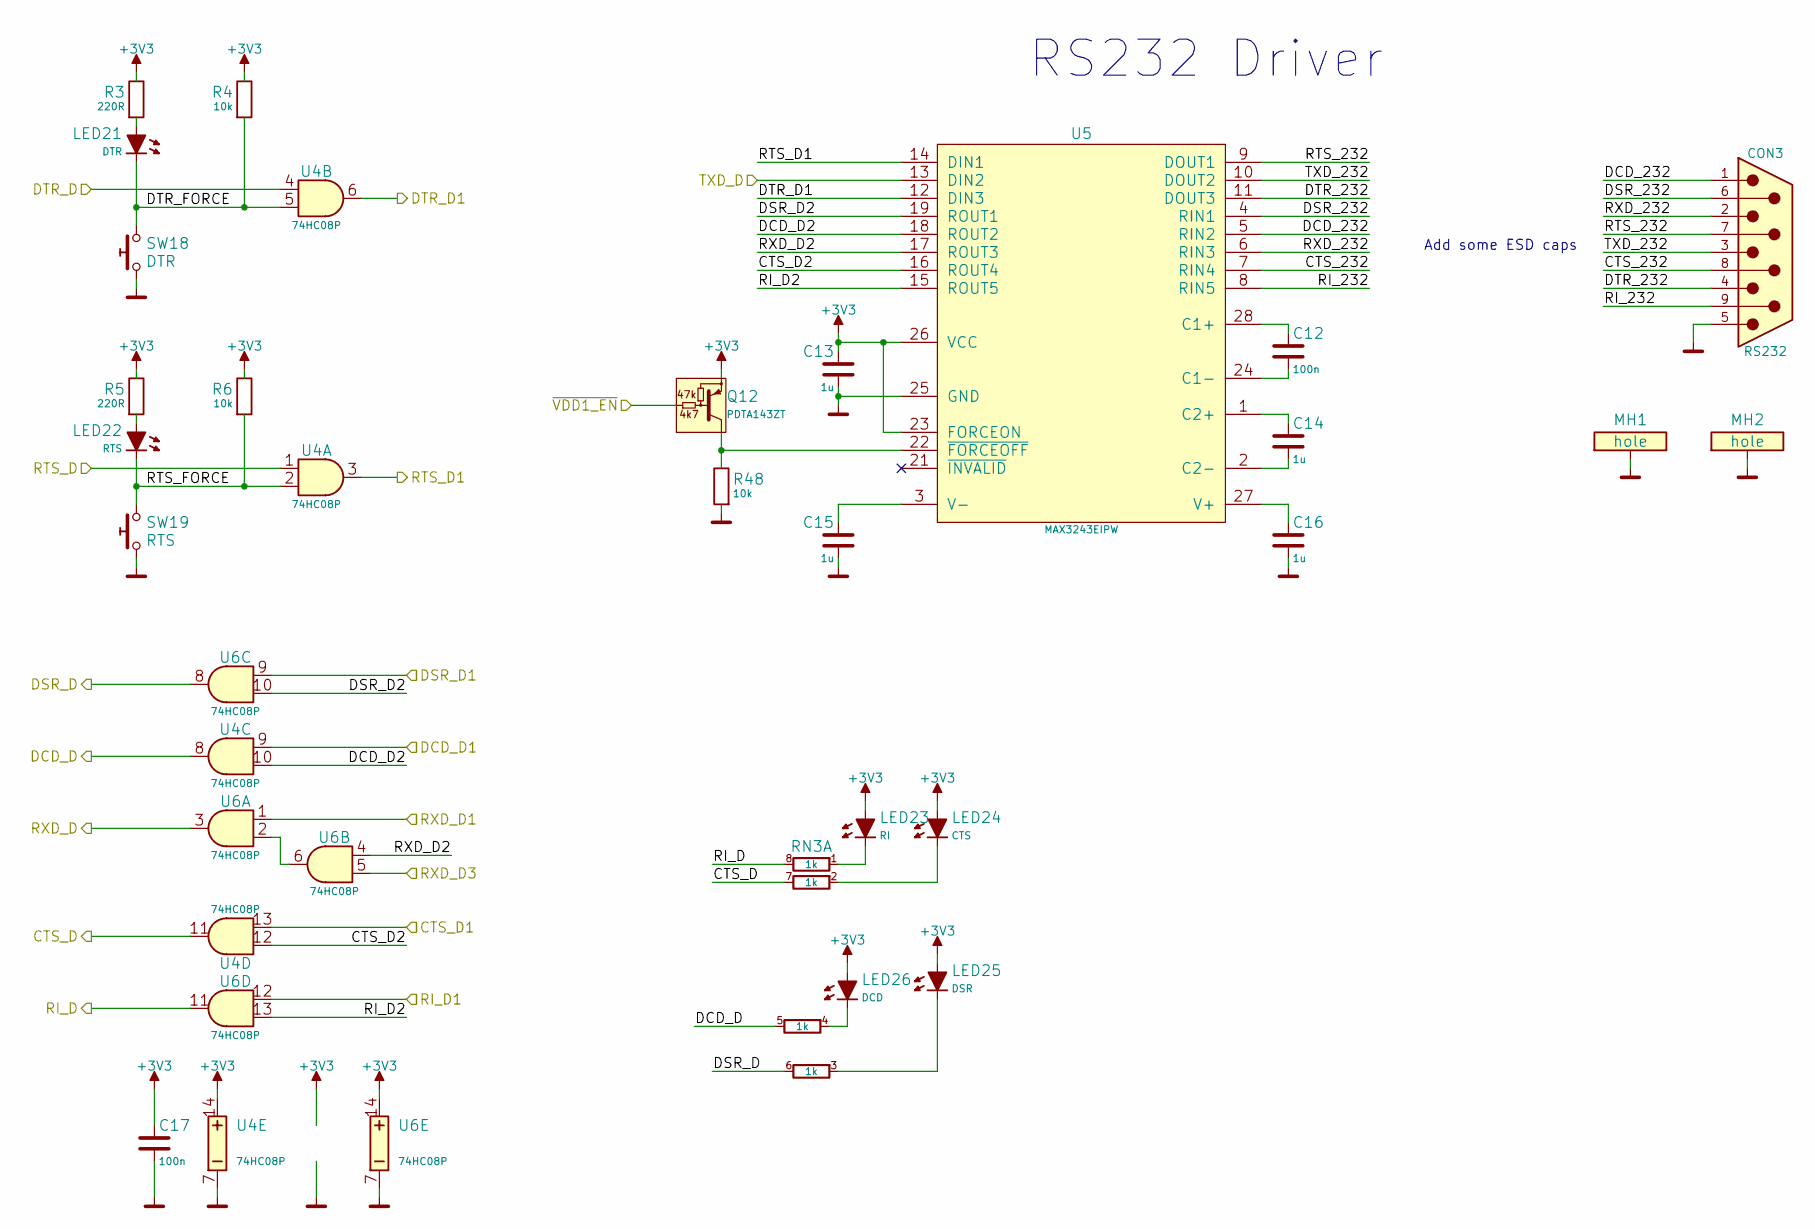
[picture p16: schematic SUPER_UART_front_RS232.sch, USB-UART converter]

Parts:
C12, C17: 100n; 0603_N
C13, C14, C15, C16: 1u; 0603_N
CON3: RS232; DB9MV
LED21: DTR; 0805D
LED22: RTS; 0805D
LED23: RI; 0805D
LED24: CTS; 0805D
LED25: DSR; 0805D
LED26: DCD; 0805D
MH1, MH2: hole; mounting_hole_3.2_7.5_plated
Q12: PDTA143ZT; SOT23-3_N
R3, R5: 220R; 0603_R_N
R4, R6, R48: 10k; 0603_R_N
RN3: 1k; 4x0603_N
SW18: DTR; TACTB-64K-F
SW19: RTS; TACTB-64K-F
U4, U6: 74HC08P; TSSOP-14_N
U5: MAX3243EIPW; TSSOP-28_N

Connections:
+3V3: C13.1, C17.1, LED23.2 (C), LED24.2 (C), LED25.2 (C), LED26.2 (C), Q12.2 (E), R3.2, R4.2, R5.2, R6.2, U4.14 (VCC), U5.23 (FORCEON), U5.26 (VCC), U6.14 (VCC); also elsewhere on the board
/CTS_D: RN3.7, U4.11 (OUT); also elsewhere on the board
/DCD_D: RN3.5, U4.8 (OUT); also elsewhere on the board
/DSR_D: RN3.6, U6.8 (OUT); also elsewhere on the board
/DTR_D: U4.4 (in1); also elsewhere on the board
/RI_D: RN3.8, U6.11 (OUT); also elsewhere on the board
/RTS_D: U4.1 (in1); also elsewhere on the board
/RXD_D: U6.3 (OUT); also elsewhere on the board
/SUPER_UART_front_RS232/CTS_232: CON3.8, U5.7 (RIN4)
/SUPER_UART_front_RS232/CTS_D1: U4.13 (in2); also elsewhere on the board
/SUPER_UART_front_RS232/CTS_D2: U4.12 (in1), U5.16 (ROUT4)
/SUPER_UART_front_RS232/DCD_232: CON3.1, U5.5 (RIN2)
/SUPER_UART_front_RS232/DCD_D1: U4.9 (in1); also elsewhere on the board
/SUPER_UART_front_RS232/DCD_D2: U4.10 (in2), U5.18 (ROUT2)
/SUPER_UART_front_RS232/DSR_232: CON3.6, U5.4 (RIN1)
/SUPER_UART_front_RS232/DSR_D1: U6.9 (in1); also elsewhere on the board
/SUPER_UART_front_RS232/DSR_D2: U5.19 (ROUT1), U6.10 (in2)
/SUPER_UART_front_RS232/DTR_232: CON3.4, U5.11 (DOUT3)
/SUPER_UART_front_RS232/DTR_D1: U4.6 (OUT), U5.12 (DIN3); also elsewhere on the board
/SUPER_UART_front_RS232/DTR_FORCE: LED21.1 (A), R4.1, SW18.1, U4.5 (in2)
/SUPER_UART_front_RS232/RI_232: CON3.9, U5.8 (RIN5)
/SUPER_UART_front_RS232/RI_D1: U6.12 (in1); also elsewhere on the board
/SUPER_UART_front_RS232/RI_D2: U5.15 (ROUT5), U6.13 (in2)
/SUPER_UART_front_RS232/RTS_232: CON3.7, U5.9 (DOUT1)
/SUPER_UART_front_RS232/RTS_D1: U4.3 (OUT), U5.14 (DIN1); also elsewhere on the board
/SUPER_UART_front_RS232/RTS_FORCE: LED22.1 (A), R6.1, SW19.1, U4.2 (in2)
/SUPER_UART_front_RS232/RXD_232: CON3.2, U5.6 (RIN3)
/SUPER_UART_front_RS232/RXD_D1: U6.1 (in1); also elsewhere on the board
/SUPER_UART_front_RS232/RXD_D2: U5.17 (ROUT3), U6.4 (in1)
/SUPER_UART_front_RS232/RXD_D3: U6.5 (in2); also elsewhere on the board
/SUPER_UART_front_RS232/TXD_232: CON3.3, U5.10 (DOUT2)
/SUPER_UART_front_RS232/~VDD1_EN: Q12.1 (B); also elsewhere on the board
/TXD_D: U5.13 (DIN2); also elsewhere on the board
GND: C13.2, C15.2, C16.2, C17.2, CON3.5, MH1.1, MH2.1, R48.1, SW18.2, SW19.2, U4.7 (GND), U5.25 (GND), U6.7 (GND); also elsewhere on the board
unnamed: C12.1, U5.28 (C1+)
unnamed: C12.2, U5.24 (C1-)
unnamed: C14.1, U5.1 (C2+)
unnamed: C14.2, U5.2 (C2-)
unnamed: C15.1, U5.3 (V-)
unnamed: C16.1, U5.27 (V+)
unnamed: LED21.2 (C), R3.1
unnamed: LED22.2 (C), R5.1
unnamed: LED23.1 (A), RN3.1
unnamed: LED24.1 (A), RN3.2
unnamed: LED25.1 (A), RN3.3
unnamed: LED26.1 (A), RN3.4
unnamed: Q12.3 (C), R48.2, U5.22 (~FORCEOFF)
unnamed: U6.2 (in2), U6.6 (OUT)

Notes on the sheet:
RS232 Driver
Add some ESD caps

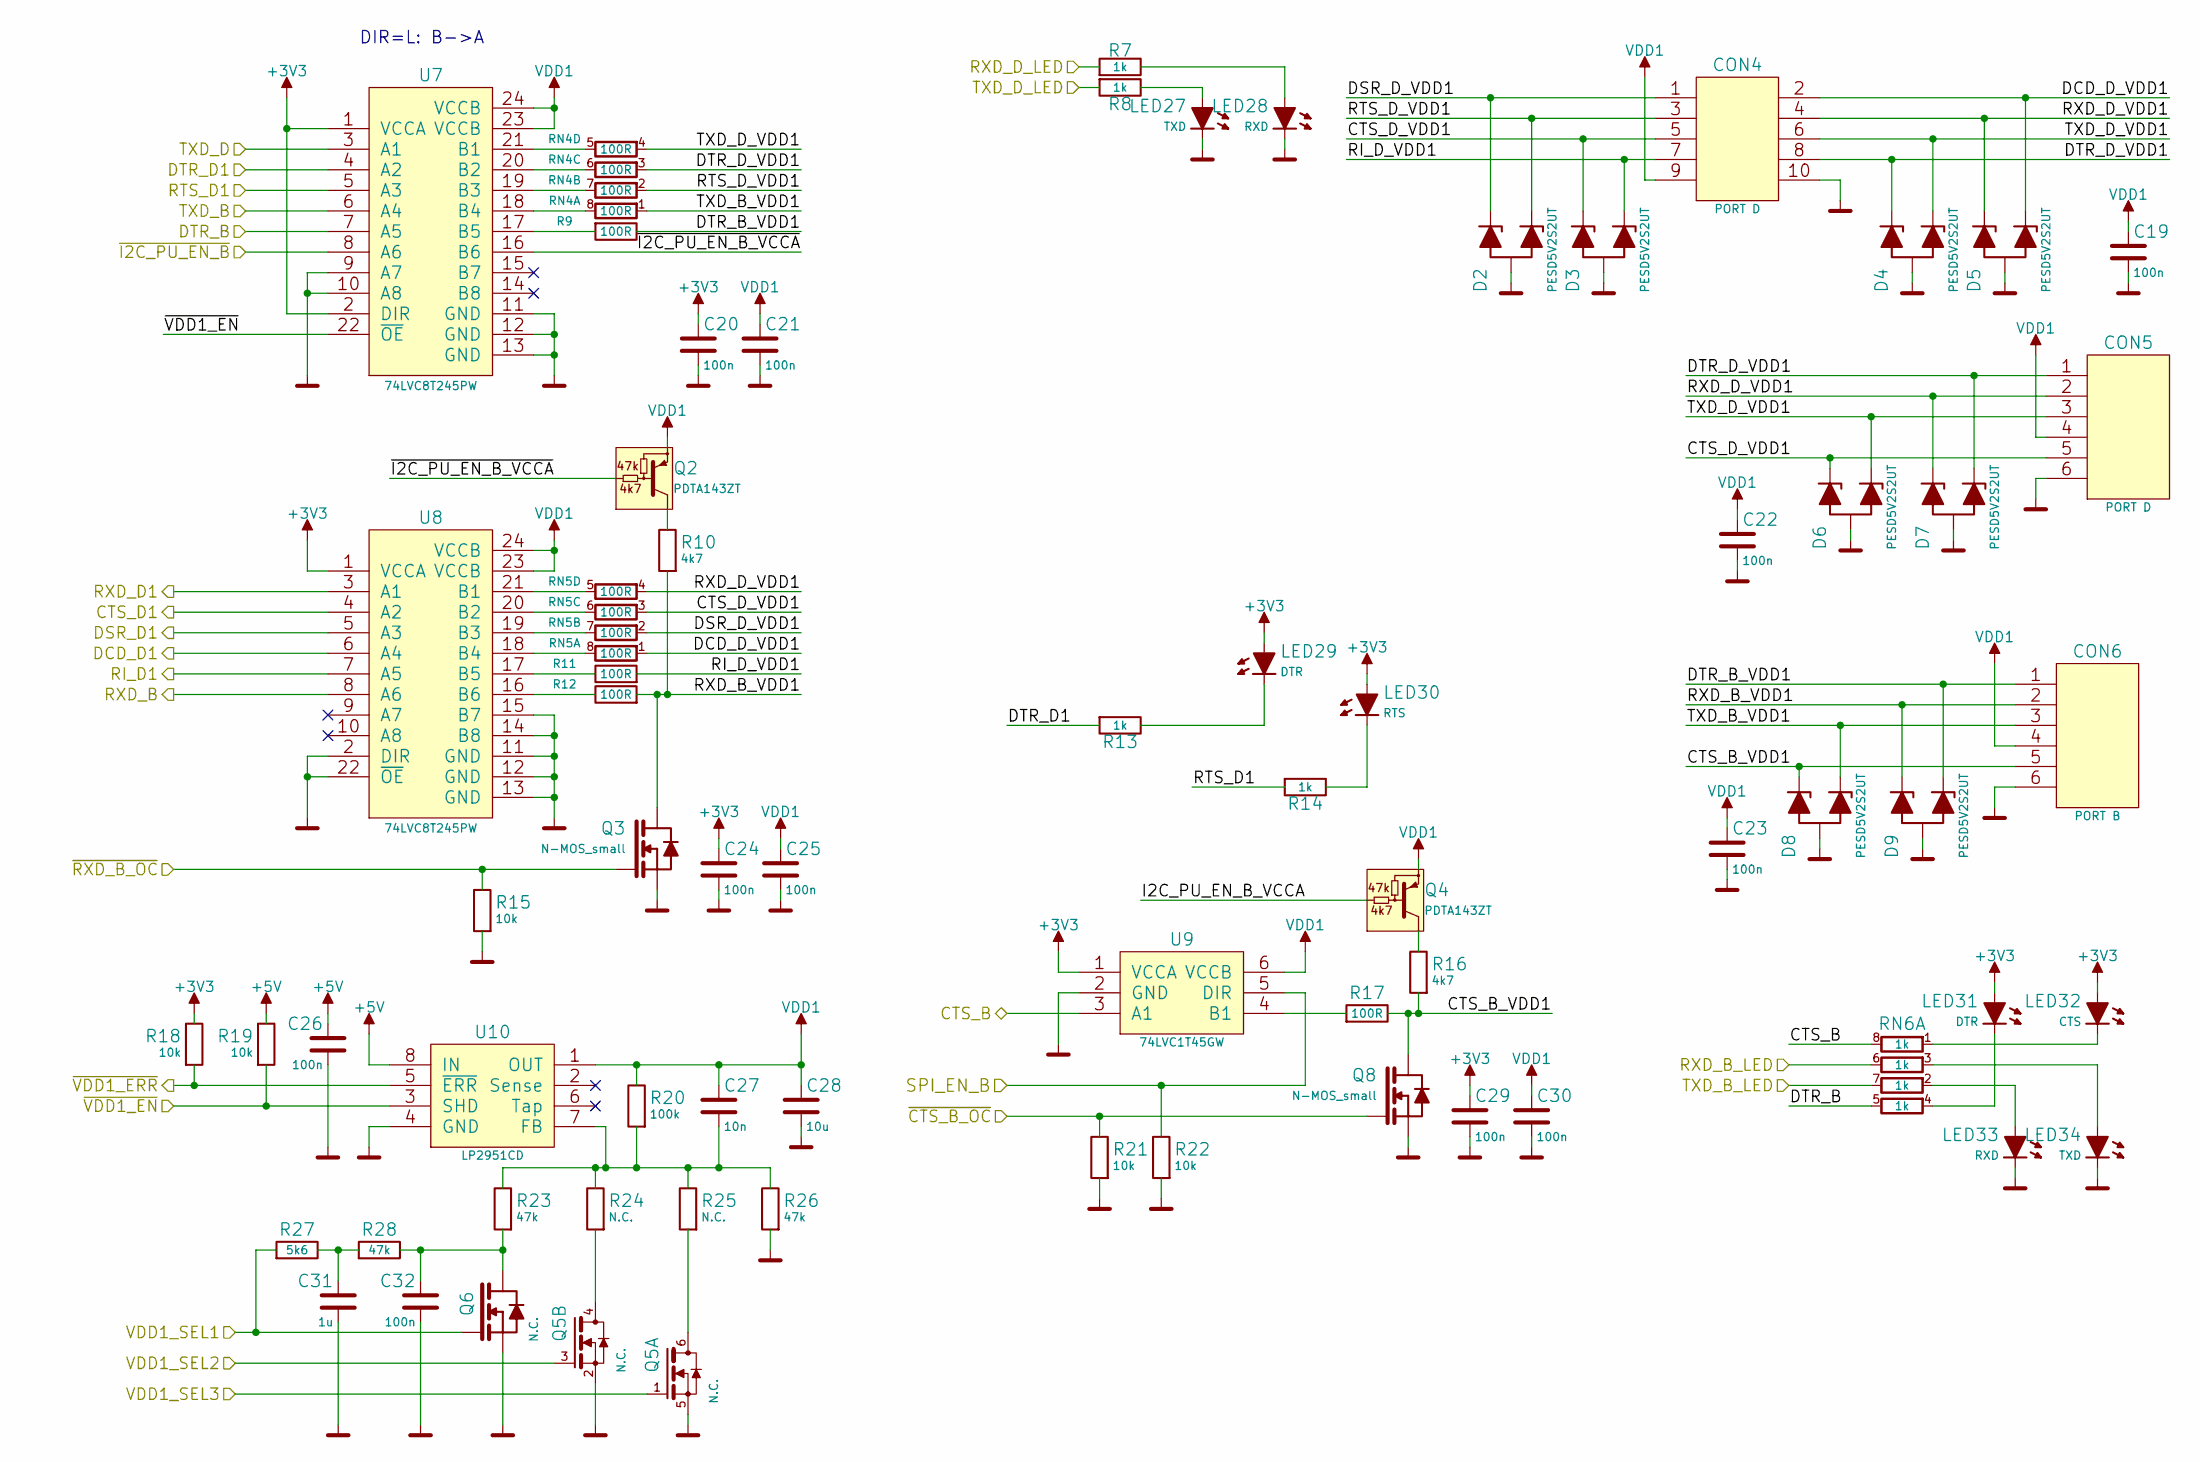
[picture p17: schematic SUPER_UART_front_UART1.sch, USB-UART converter]

Parts:
C19, C20, C21, C22, C23, C24, C25, C26, C29, C30, C32: 100n; 0603_N
C27: 10n; 0603_N
C28: 10u; 0805_N
C31: 1u; 0603_N
CON4: PORT D; IDC10
CON5: PORT D; NIGINI_NCDW-06
CON6: PORT B; NIGINI_NCDW-06
D2, D3, D4, D5, D6, D7, D8, D9: PESD5V2S2UT; SOT23-3_N
LED27, LED34: TXD; 0805D
LED28, LED33: RXD; 0805D
LED29, LED31: DTR; 0805D
LED30: RTS; 0805D
LED32: CTS; 0805D
Q2, Q4: PDTA143ZT; SOT23-3_N
Q3, Q8: N-MOS_small; SOT23-3_N
Q5: N.C.; SC70-6_N
Q6: N.C.; SOT23-3_N
R7, R8, R13, R14: 1k; 0603_R_N
R9, R11, R12, R17: 100R; 0603_R_N
R10, R16: 4k7; 0603_R_N
R15, R18, R19, R21, R22: 10k; 0603_R_N
R20: 100k; 0603_R_N
R23, R26, R28: 47k; 0603_R_N
R24, R25: N.C.; 0603_R_N
R27: 5k6; 0603_R_N
RN4, RN5: 100R; 4x0603_N
RN6: 1k; 4x0603_N
U7, U8: 74LVC8T245PW; TI_TSSOP-24_N
U9: 74LVC1T45GW; SC70-6_N
U10: LP2951CD; SOIC-8_N

Connections:
+3V3: C20.1, C24.1, C29.1, LED29.2 (C), LED30.2 (C), LED31.2 (C), LED32.2 (C), R18.2, U7.1 (VCCA), U7.2 (DIR), U8.1 (VCCA), U9.1 (VCCA); also elsewhere on the board
+5V: C26.1, R19.2, U10.8 (IN); also elsewhere on the board
/CTS_B: RN6.8, U9.3 (A1); also elsewhere on the board
/DTR_B: RN6.5, U7.7 (A5); also elsewhere on the board
/RXD_B: U8.8 (A6); also elsewhere on the board
/SUPER_UART_front_RS232/CTS_D1: U8.4 (A2); also elsewhere on the board
/SUPER_UART_front_RS232/DCD_D1: U8.6 (A4); also elsewhere on the board
/SUPER_UART_front_RS232/DSR_D1: U8.5 (A3); also elsewhere on the board
/SUPER_UART_front_RS232/DTR_D1: R13.1, U7.4 (A2); also elsewhere on the board
/SUPER_UART_front_RS232/RI_D1: U8.7 (A5); also elsewhere on the board
/SUPER_UART_front_RS232/RTS_D1: R14.1, U7.5 (A3); also elsewhere on the board
/SUPER_UART_front_RS232/RXD_D1: U8.3 (A1); also elsewhere on the board
/SUPER_UART_front_RS232/~VDD1_EN: R19.1, U7.22 (~OE), U10.3 (SHD); also elsewhere on the board
/SUPER_UART_front_UART1/CTS_B_VDD1: CON6.5, D8.1 (C1), Q8.3 (D), R16.1, R17.2
/SUPER_UART_front_UART1/CTS_D_VDD1: CON4.5, CON5.5, D3.1 (C1), D6.1 (C1), RN5.3
/SUPER_UART_front_UART1/DCD_D_VDD1: CON4.2, D5.2 (C2), RN5.1
/SUPER_UART_front_UART1/DSR_D_VDD1: CON4.1, D2.1 (C1), RN5.2
/SUPER_UART_front_UART1/DTR_B_VDD1: CON6.1, D9.2 (C2), R9.2
/SUPER_UART_front_UART1/DTR_D_VDD1: CON4.8, CON5.1, D4.1 (C1), D7.2 (C2), RN4.3
/SUPER_UART_front_UART1/I2C_PU_EN_B: U7.8 (A6); also elsewhere on the board
/SUPER_UART_front_UART1/RI_D_VDD1: CON4.7, D3.2 (C2), R11.1
/SUPER_UART_front_UART1/RTS_D_VDD1: CON4.3, D2.2 (C2), RN4.2
/SUPER_UART_front_UART1/RXD_B_LED: RN6.6; also elsewhere on the board
/SUPER_UART_front_UART1/RXD_B_VDD1: CON6.2, D9.1 (C1), Q3.3 (D), R10.1, R12.1
/SUPER_UART_front_UART1/RXD_D_LED: R7.1; also elsewhere on the board
/SUPER_UART_front_UART1/RXD_D_VDD1: CON4.4, CON5.2, D5.1 (C1), D7.1 (C1), RN5.4
/SUPER_UART_front_UART1/SPI_EN_B: R22.2, U9.5 (DIR); also elsewhere on the board
/SUPER_UART_front_UART1/TXD_B_LED: RN6.7; also elsewhere on the board
/SUPER_UART_front_UART1/TXD_B_VDD1: CON6.3, D8.2 (C2), RN4.1
/SUPER_UART_front_UART1/TXD_D_LED: R8.1; also elsewhere on the board
/SUPER_UART_front_UART1/TXD_D_VDD1: CON4.6, CON5.3, D4.2 (C2), D6.2 (C2), RN4.4
/SUPER_UART_front_UART1/VDD1_SEL1: Q6.1 (G), R27.1; also elsewhere on the board
/SUPER_UART_front_UART1/VDD1_SEL2: Q5.3 (G); also elsewhere on the board
/SUPER_UART_front_UART1/VDD1_SEL3: Q5.1 (G); also elsewhere on the board
/SUPER_UART_front_UART1/~VDD1_ERR: R18.1, U10.5 (~ERR); also elsewhere on the board
/TXD_B: U7.6 (A4); also elsewhere on the board
/TXD_D: U7.3 (A1); also elsewhere on the board
/~CTS_B_OC: Q8.1 (G), R21.2; also elsewhere on the board
/~RXD_B_OC: Q3.1 (G), R15.2; also elsewhere on the board
GND: C19.2, C20.2, C21.2, C22.2, C23.2, C24.2, C25.2, C26.2, C28.2, C29.2, C30.2, C31.2, C32.2, CON4.10, CON5.6, CON6.6, D2.3 (A), D3.3 (A), D4.3 (A), D5.3 (A), D6.3 (A), D7.3 (A), D8.3 (A), D9.3 (A), LED27.1 (A), LED28.1 (A), LED33.1 (A), LED34.1 (A), Q3.2 (S), Q5.2 (S), Q5.5 (S), Q6.2 (S), Q8.2 (S), R15.1, R21.1, R22.1, R26.1, U7.9 (A7), U7.10 (A8), U7.11 (GND), U7.12 (GND), U7.13 (GND), U8.2 (DIR), U8.11 (GND), U8.12 (GND), U8.13 (GND), U8.14 (B8), U8.15 (B7), U8.22 (~OE), U9.2 (GND), U10.4 (GND); also elsewhere on the board
unnamed: C27.2, R20.1, R23.2, R24.2, R25.2, R26.2, U10.7 (FB)
unnamed: C31.1, R27.2, R28.1
unnamed: C32.1, Q6.3 (D), R23.1, R28.2
unnamed: LED27.2 (C), R8.2
unnamed: LED28.2 (C), R7.2
unnamed: LED29.1 (A), R13.2
unnamed: LED30.1 (A), R14.2
unnamed: LED31.1 (A), RN6.4
unnamed: LED32.1 (A), RN6.1
unnamed: LED33.2 (C), RN6.2
unnamed: LED34.2 (C), RN6.3
unnamed: Q2.3 (C), R10.2
unnamed: Q4.3 (C), R16.2
unnamed: Q5.4 (D), R24.1
unnamed: Q5.6 (D), R25.1
unnamed: R9.1, U7.17 (B5)
unnamed: R11.2, U8.17 (B5)
unnamed: R12.2, U8.16 (B6)
unnamed: R17.1, U9.4 (B1)
unnamed: RN4.5, U7.21 (B1)
unnamed: RN4.6, U7.20 (B2)
unnamed: RN4.7, U7.19 (B3)
unnamed: RN4.8, U7.18 (B4)
unnamed: RN5.5, U8.21 (B1)
unnamed: RN5.6, U8.20 (B2)
unnamed: RN5.7, U8.19 (B3)
unnamed: RN5.8, U8.18 (B4)
VDD1: C19.1, C21.1, C22.1, C23.1, C25.1, C27.1, C28.1, C30.1, CON4.9, CON5.4, CON6.4, Q2.2 (E), Q4.2 (E), R20.2, U7.23 (VCCB), U7.24 (VCCB), U8.23 (VCCB), U8.24 (VCCB), U9.6 (VCCB), U10.1 (OUT); also elsewhere on the board

Notes on the sheet:
DIR=L: B->A
