NiceCircuits/SUPER_UART/kicad/front/SUPER_UART_front.kicad_pcb

## KiCad design kicad/front/SUPER_UART_front.kicad_pcb (continued)

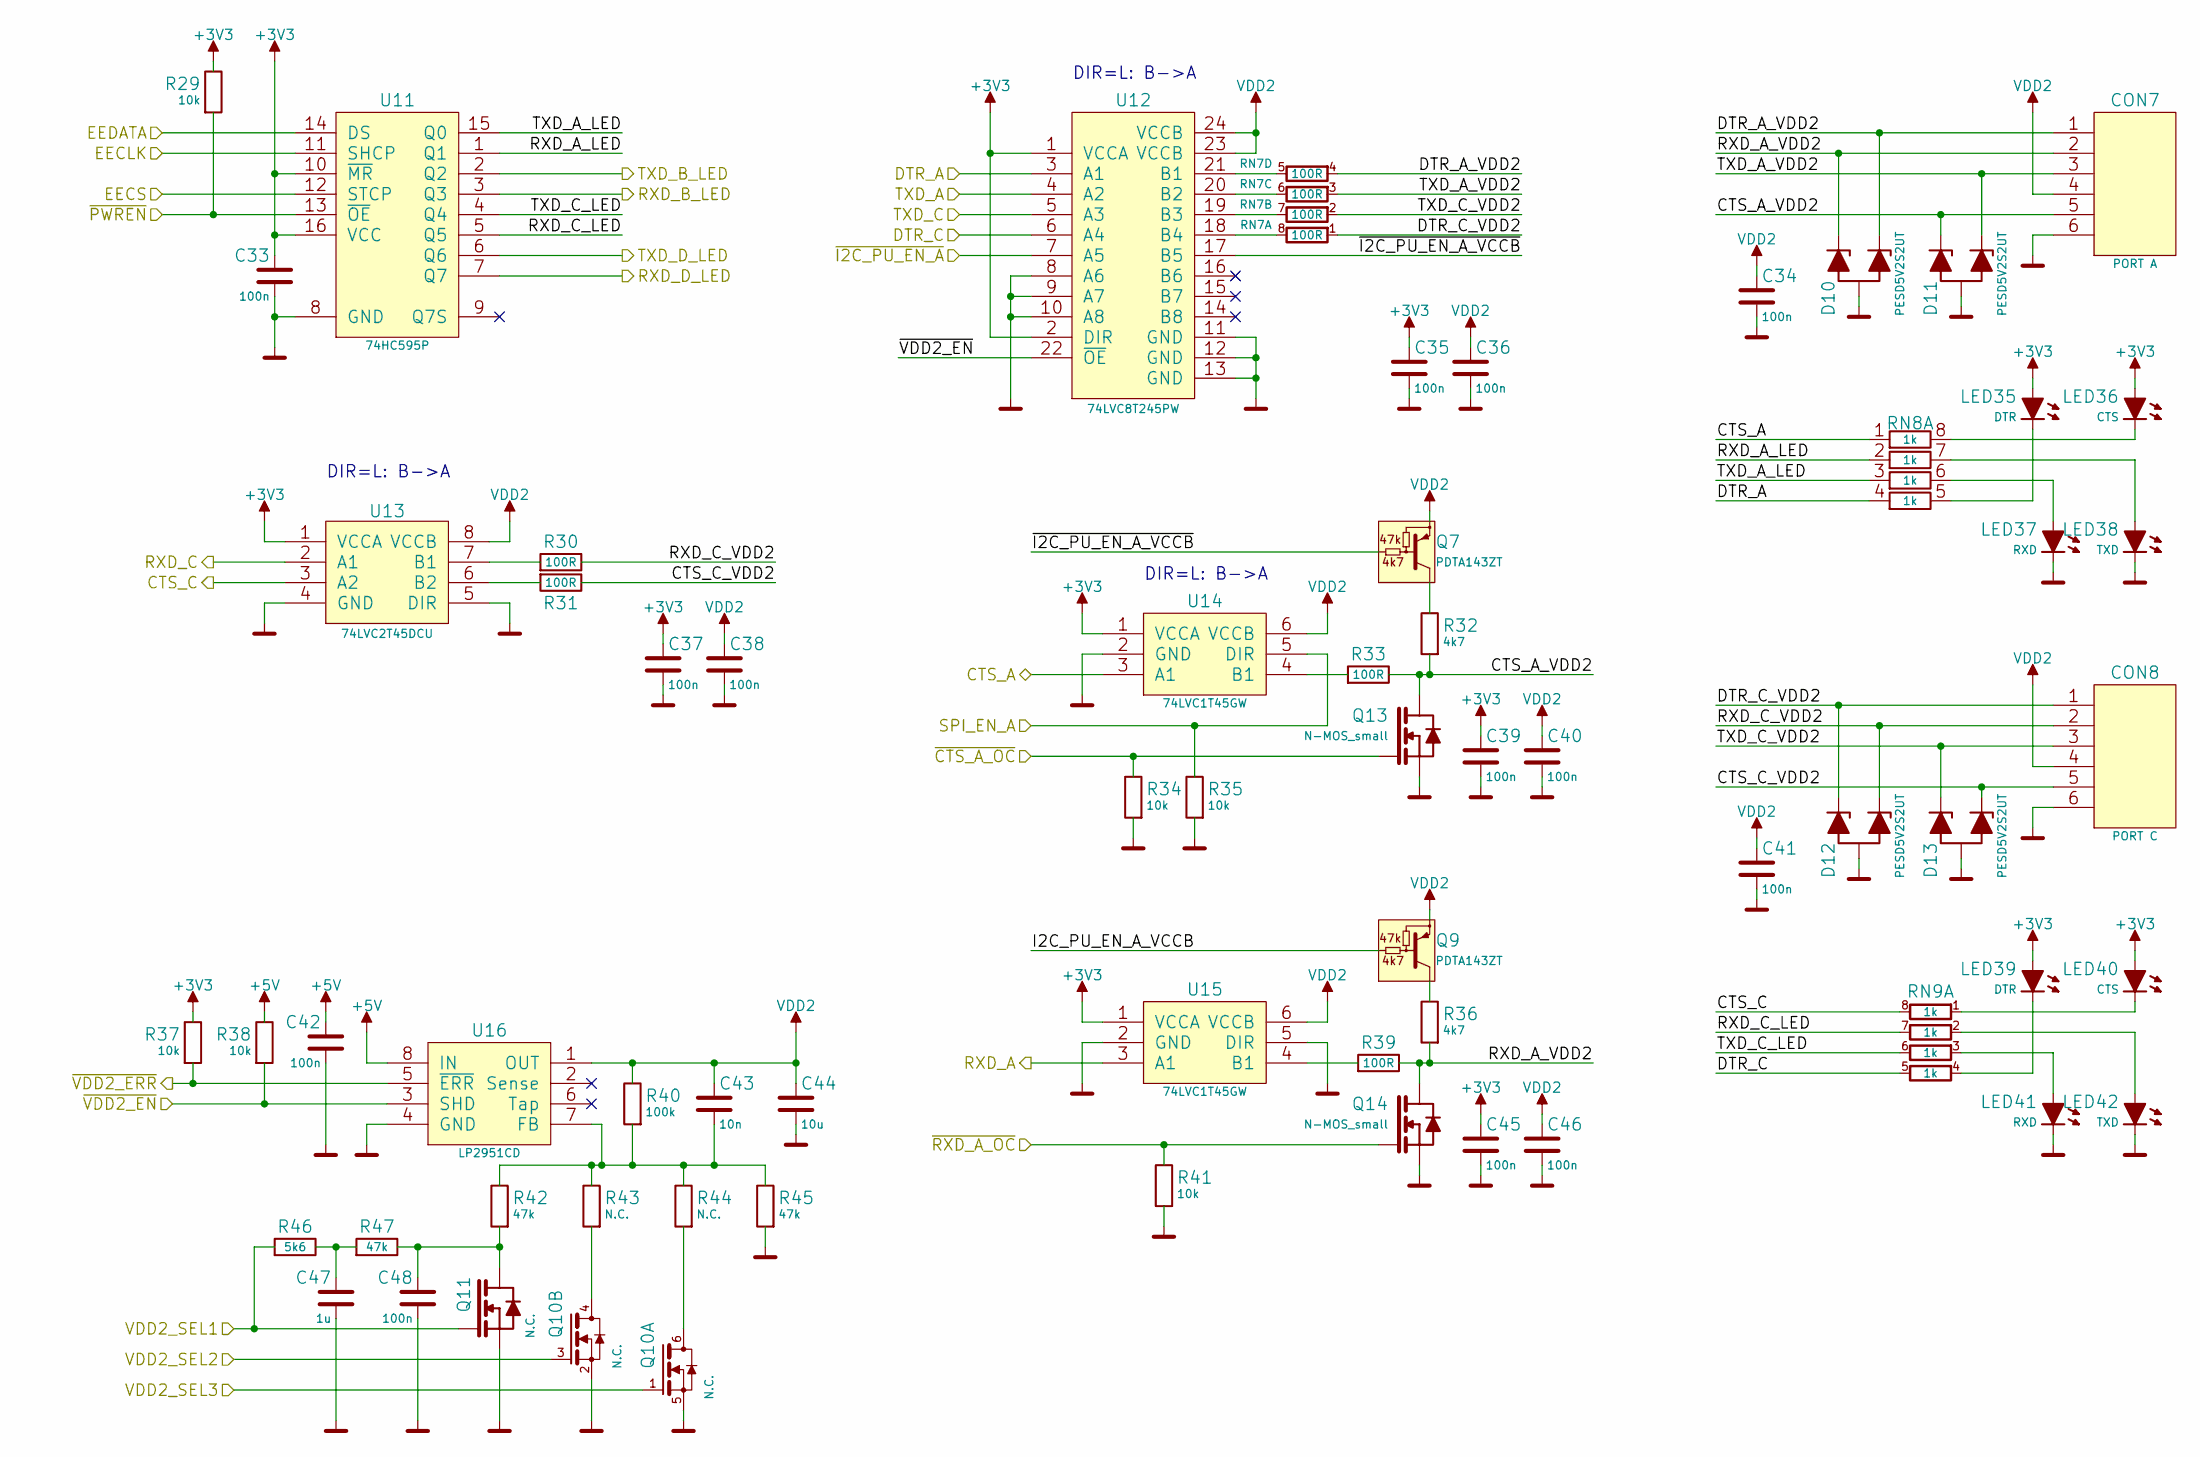
[picture p18: schematic SUPER_UART_front_UART234.sch, USB-UART converter]

Parts:
C33, C34, C35, C36, C37, C38, C39, C40, C41, C42, C45, C46, C48: 100n; 0603_N
C43: 10n; 0603_N
C44: 10u; 0805_N
C47: 1u; 0603_N
CON7: PORT A; NIGINI_NCDW-06
CON8: PORT C; NIGINI_NCDW-06
D10, D11, D12, D13: PESD5V2S2UT; SOT23-3_N
LED35, LED39: DTR; 0805D
LED36, LED40: CTS; 0805D
LED37, LED41: RXD; 0805D
LED38, LED42: TXD; 0805D
Q7, Q9: PDTA143ZT; SOT23-3_N
Q10: N.C.; SC70-6_N
Q11: N.C.; SOT23-3_N
Q13, Q14: N-MOS_small; SOT23-3_N
R29, R34, R35, R37, R38, R41: 10k; 0603_R_N
R30, R31, R33, R39: 100R; 0603_R_N
R32, R36: 4k7; 0603_R_N
R40: 100k; 0603_R_N
R42, R45, R47: 47k; 0603_R_N
R43, R44: N.C.; 0603_R_N
R46: 5k6; 0603_R_N
RN7: 100R; 4x0603_N
RN8, RN9: 1k; 4x0603_N
U11: 74HC595P; TSSOP-16_N
U12: 74LVC8T245PW; TI_TSSOP-24_N
U13: 74LVC2T45DCU; TI_VSSOP-8_N
U14, U15: 74LVC1T45GW; SC70-6_N
U16: LP2951CD; SOIC-8_N

Connections:
+3V3: C33.1, C35.1, C37.1, C39.1, C45.1, LED35.2 (C), LED36.2 (C), LED39.2 (C), LED40.2 (C), R29.2, R37.2, U11.10 (~MR), U11.16 (VCC), U12.1 (VCCA), U12.2 (DIR), U13.1 (VCCA), U14.1 (VCCA), U15.1 (VCCA); also elsewhere on the board
+5V: C42.1, R38.2, U16.8 (IN); also elsewhere on the board
/CTS_A: RN8.1, U14.3 (A1); also elsewhere on the board
/CTS_C: RN9.8, U13.3 (A2); also elsewhere on the board
/DTR_A: RN8.4 (1), U12.3 (A1); also elsewhere on the board
/DTR_C: RN9.5, U12.6 (A4); also elsewhere on the board
/EECLK: U11.11 (SHCP); also elsewhere on the board
/EECS: U11.12 (STCP); also elsewhere on the board
/EEDATA: U11.14 (DS); also elsewhere on the board
/RXD_A: U15.3 (A1); also elsewhere on the board
/RXD_C: U13.2 (A1); also elsewhere on the board
/SUPER_UART_front_UART1/RXD_B_LED: U11.3 (Q3); also elsewhere on the board
/SUPER_UART_front_UART1/RXD_D_LED: U11.7 (Q7); also elsewhere on the board
/SUPER_UART_front_UART1/TXD_B_LED: U11.2 (Q2); also elsewhere on the board
/SUPER_UART_front_UART1/TXD_D_LED: U11.6 (Q6); also elsewhere on the board
/SUPER_UART_front_UART234/CTS_A_VDD2: CON7.5, D11.1 (C1), Q13.3 (D), R32.1, R33.2
/SUPER_UART_front_UART234/CTS_C_VDD2: CON8.5, D13.2 (C2), R31.2
/SUPER_UART_front_UART234/DTR_A_VDD2: CON7.1, D10.2 (C2), RN7.4
/SUPER_UART_front_UART234/DTR_C_VDD2: CON8.1, D12.1 (C1), RN7.1
/SUPER_UART_front_UART234/I2C_PU_EN_A: U12.7 (A5); also elsewhere on the board
/SUPER_UART_front_UART234/RXD_A_LED: RN8.2 (1), U11.1 (Q1)
/SUPER_UART_front_UART234/RXD_A_VDD2: CON7.2, D10.1 (C1), Q14.3 (D), R36.1, R39.2
/SUPER_UART_front_UART234/RXD_C_LED: RN9.7, U11.5 (Q5)
/SUPER_UART_front_UART234/RXD_C_VDD2: CON8.2, D12.2 (C2), R30.2
/SUPER_UART_front_UART234/SPI_EN_A: R35.2, U14.5 (DIR); also elsewhere on the board
/SUPER_UART_front_UART234/TXD_A_LED: RN8.3 (1), U11.15 (Q0)
/SUPER_UART_front_UART234/TXD_A_VDD2: CON7.3, D11.2 (C2), RN7.3
/SUPER_UART_front_UART234/TXD_C_LED: RN9.6, U11.4 (Q4)
/SUPER_UART_front_UART234/TXD_C_VDD2: CON8.3, D13.1 (C1), RN7.2
/SUPER_UART_front_UART234/VDD2_SEL1: Q11.1 (G), R46.1; also elsewhere on the board
/SUPER_UART_front_UART234/VDD2_SEL2: Q10.3 (G); also elsewhere on the board
/SUPER_UART_front_UART234/VDD2_SEL3: Q10.1 (G); also elsewhere on the board
/SUPER_UART_front_UART234/~VDD2_EN: R38.1, U12.22 (~OE), U16.3 (SHD); also elsewhere on the board
/SUPER_UART_front_UART234/~VDD2_ERR: R37.1, U16.5 (~ERR); also elsewhere on the board
/TXD_A: U12.4 (A2); also elsewhere on the board
/TXD_C: U12.5 (A3); also elsewhere on the board
/~CTS_A_OC: Q13.1 (G), R34.2; also elsewhere on the board
/~PWREN: R29.1, U11.13 (~OE); also elsewhere on the board
/~RXD_A_OC: Q14.1 (G), R41.2; also elsewhere on the board
GND: C33.2, C34.2, C35.2, C36.2, C37.2, C38.2, C39.2, C40.2, C41.2, C42.2, C44.2, C45.2, C46.2, C47.2, C48.2, CON7.6, CON8.6, D10.3 (A), D11.3 (A), D12.3 (A), D13.3 (A), LED37.1 (A), LED38.1 (A), LED41.1 (A), LED42.1 (A), Q10.2 (S), Q10.5 (S), Q11.2 (S), Q13.2 (S), Q14.2 (S), R34.1, R35.1, R41.1, R45.1, U11.8 (GND), U12.8 (A6), U12.9 (A7), U12.10 (A8), U12.11 (GND), U12.12 (GND), U12.13 (GND), U13.4 (GND), U13.5 (DIR), U14.2 (GND), U15.2 (GND), U15.5 (DIR), U16.4 (GND); also elsewhere on the board
unnamed: C43.2, R40.1, R42.2, R43.2, R44.2, R45.2, U16.7 (FB)
unnamed: C47.1, R46.2, R47.1
unnamed: C48.1, Q11.3 (D), R42.1, R47.2
unnamed: LED35.1 (A), RN8.5 (2)
unnamed: LED36.1 (A), RN8.8 (2)
unnamed: LED37.2 (C), RN8.6 (2)
unnamed: LED38.2 (C), RN8.7 (2)
unnamed: LED39.1 (A), RN9.4
unnamed: LED40.1 (A), RN9.1
unnamed: LED41.2 (C), RN9.3
unnamed: LED42.2 (C), RN9.2
unnamed: Q7.3 (C), R32.2
unnamed: Q9.3 (C), R36.2
unnamed: Q10.4 (D), R43.1
unnamed: Q10.6 (D), R44.1
unnamed: R30.1, U13.7 (B1)
unnamed: R31.1, U13.6 (B2)
unnamed: R33.1, U14.4 (B1)
unnamed: R39.1, U15.4 (B1)
unnamed: RN7.5, U12.21 (B1)
unnamed: RN7.6, U12.20 (B2)
unnamed: RN7.7, U12.19 (B3)
unnamed: RN7.8, U12.18 (B4)
VDD2: C34.1, C36.1, C38.1, C40.1, C41.1, C43.1, C44.1, C46.1, CON7.4, CON8.4, Q7.2 (E), Q9.2 (E), R40.2, U12.23 (VCCB), U12.24 (VCCB), U13.8 (VCCB), U14.6 (VCCB), U15.6 (VCCB), U16.1 (OUT); also elsewhere on the board

Notes on the sheet:
DIR=L: B->A

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
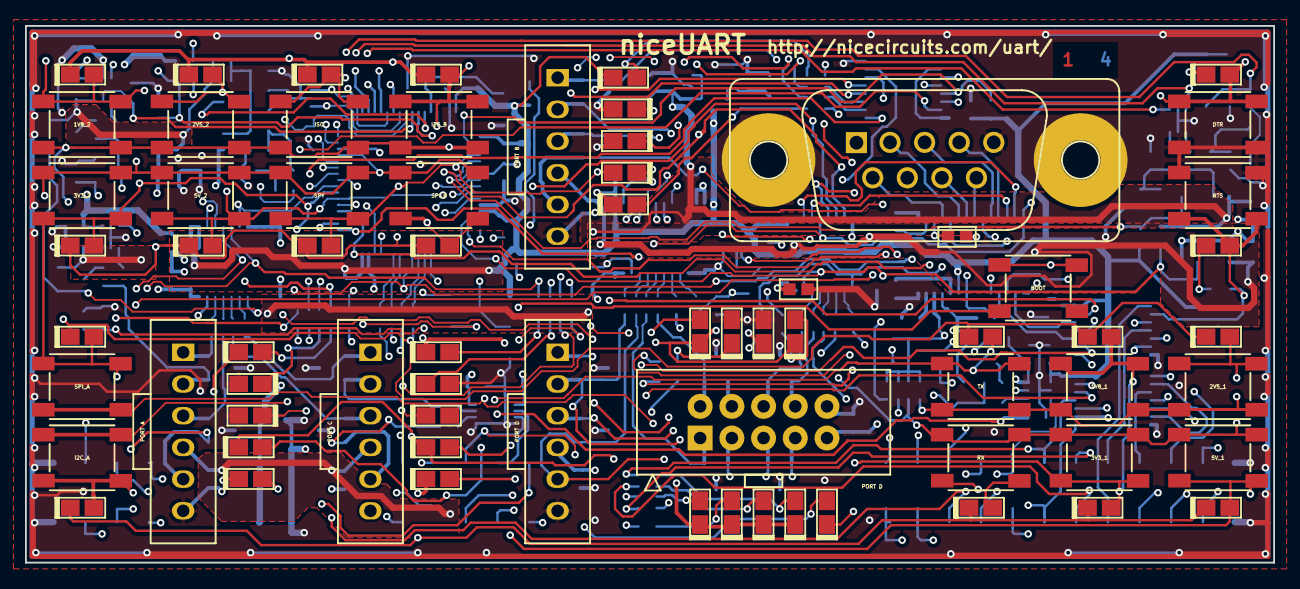
[picture p19: board SUPER_UART_front.kicad_pcb from above]

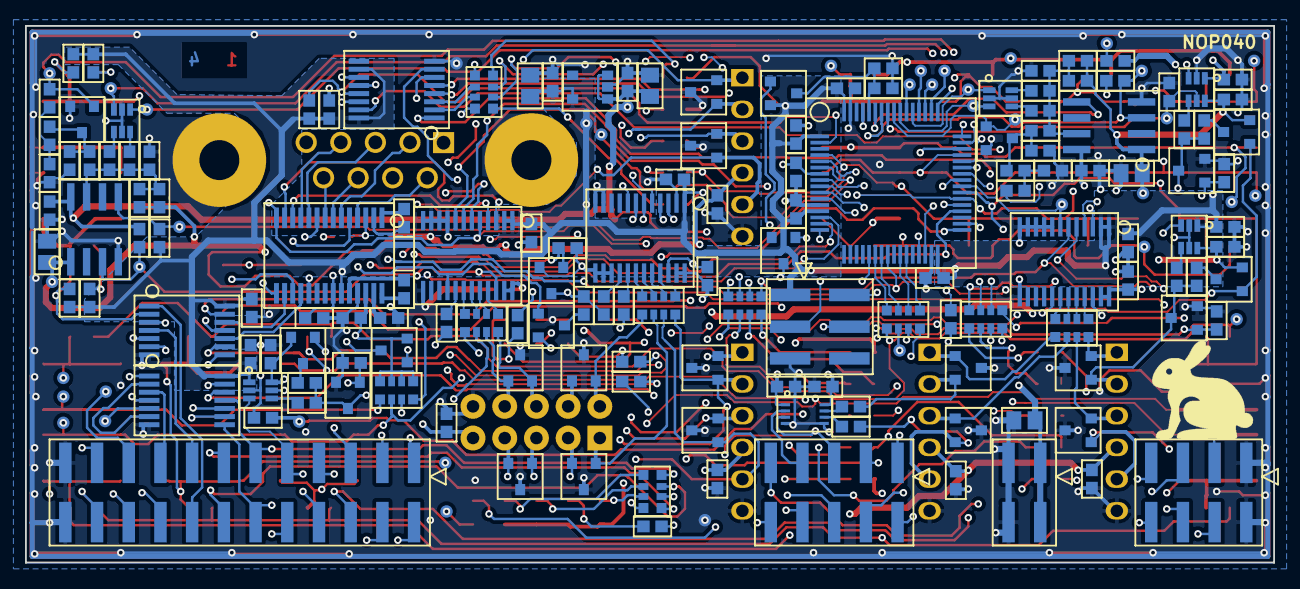
[picture p20: board SUPER_UART_front.kicad_pcb from below]

Board: 4 copper layers, 100.0 x 43.0 mm, 260 parts (188 on the bottom side), 201 nets.
