NiceCircuits/SUPER_UART/kicad/main/SUPER_UART_main.kicad_pcb

## KiCad design kicad/main/SUPER_UART_main.kicad_pcb (2020-11-18)

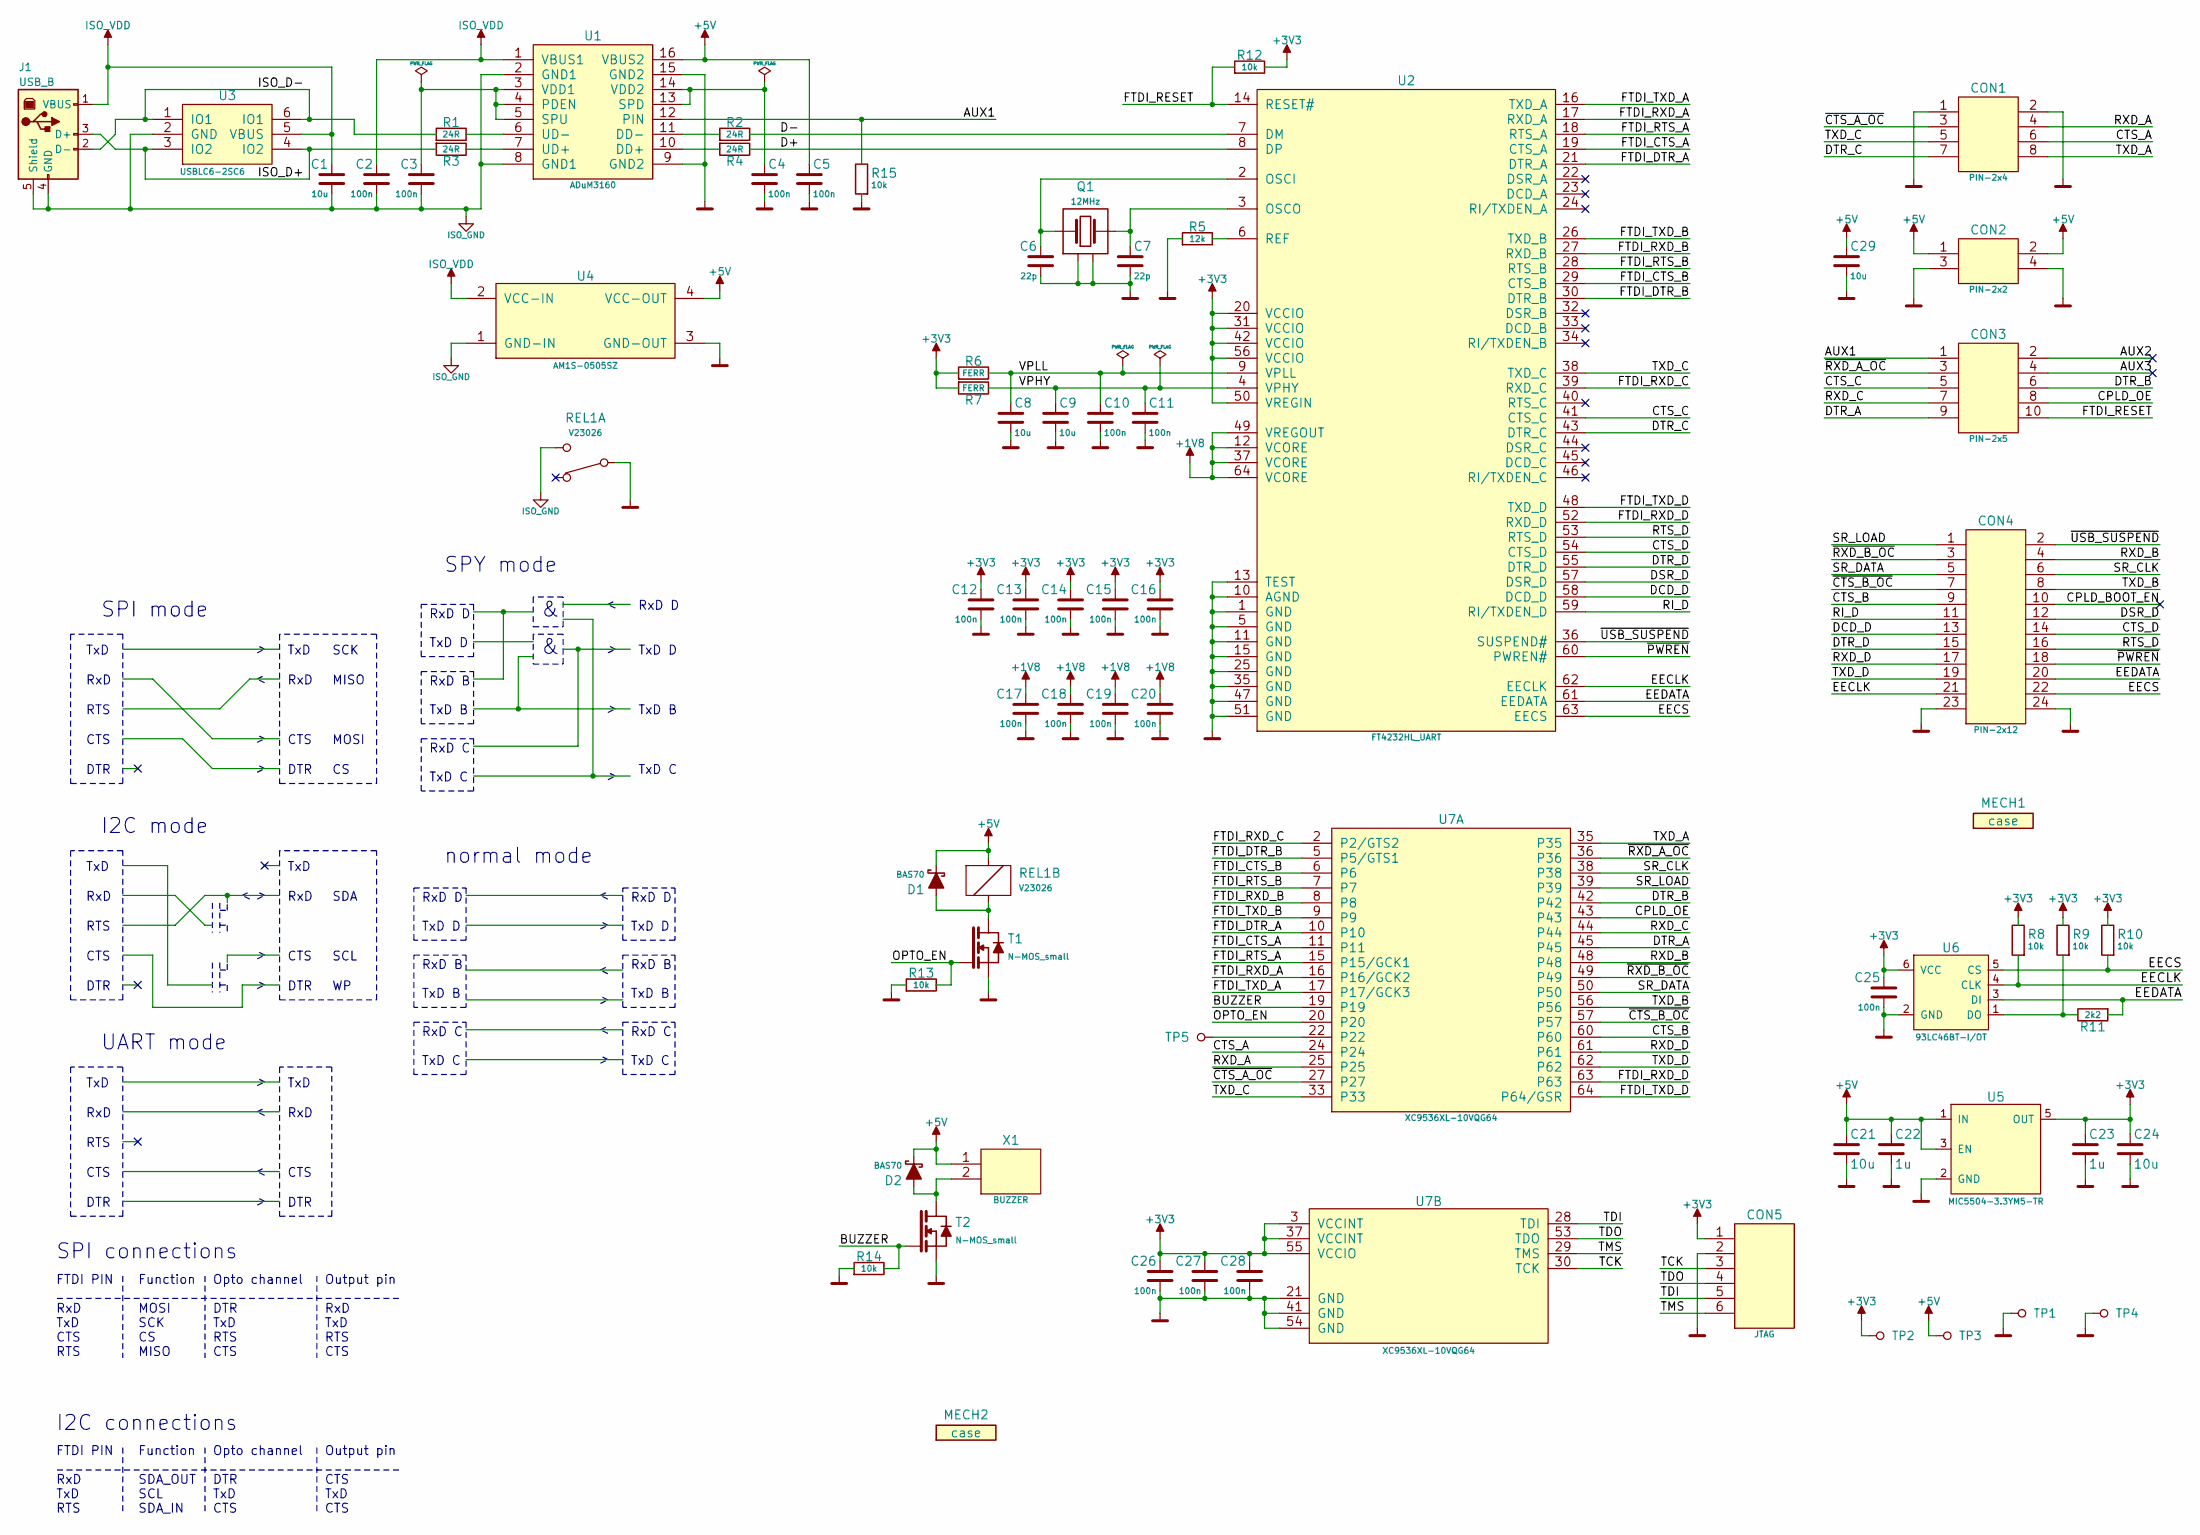
[picture p21: schematic SUPER_UART_main.sch]

Parts:
C1, C8, C9, C21, C24, C29: 10u; 0805_N
C2, C3, C4, C5, C10, C11, C12, C13, C14, C15, C16, C17, C18, C19, C20, C25, C26, C27, C28: 100n; 0603_N
C6, C7: 22p; 0603_N
C22, C23: 1u; 0603_N
CON1: PIN-2x4; PIN-2x4_F_angled_N
CON2: PIN-2x2; PIN-2x2_F_angled_N
CON3: PIN-2x5; PIN-2x5_F_angled_N
CON4: PIN-2x12; PIN-2x12_F_angled_N
CON5: JTAG; PIN-1x6_N
D1, D2: BAS70; SOT23-3_N
J1: USB_B
MECH1: case; dummy
MECH2: case; frog
Q1: 12MHz; XT3.2x2.5_N
R1, R2, R3, R4: 24R; 0603_R_N
R5: 12k; 0603_R_N
R6, R7: FERR; 0603_R_N
R8, R9, R10, R12, R13, R14, R15: 10k; 0603_R_N
R11: 2k2; 0603_R_N
REL1: V23026
T1, T2: N-MOS_small; SOT23-3_N
TP1, TP2, TP3, TP4, TP5: Testpoint; TP_1mm
U1: ADuM3160; SOIC-16_N
U2: FT4232HL_UART; FTDI_LQFP64_M
U3: USBLC6-2SC6; SOT23-6_N
U4: AM1S-0505SZ; AM1S-Z_N
U5: MIC5504-3.3YM5-TR; SOT23-5_N
U6: 93LC46BT-I/OT; SOT23-6_N
U7: XC9536XL-10VQG64; Xilinx_VQFP64_M
X1: BUZZER; buzzer_12x9.0

Connections:
+1V8: C17.1, C18.1, C19.1, C20.1, U2.12 (VCORE), U2.37 (VCORE), U2.49 (VREGOUT), U2.64 (VCORE)
+3V3: C12.1, C13.1, C14.1, C15.1, C16.1, C23.1, C24.1, C25.1, C26.1, C27.1, C28.1, CON5.1, R6.1, R7.1, R8.2, R9.2, R10.2, R12.2, TP2.1, U2.20 (VCCIO), U2.31 (VCCIO), U2.42 (VCCIO), U2.50 (VREGIN), U2.56 (VCCIO), U5.5 (OUT), U6.6 (VCC), U7.3 (VCCINT), U7.37 (VCCINT), U7.55 (VCCIO)
+5V: C5.1, C21.1, C22.1, C29.1, CON2.1, CON2.2, D1.3 (A), D2.3 (A), REL1.C1 (COIL1), TP3.1, U1.16 (VBUS2), U4.4 (VCC-OUT), U5.1 (IN), U5.3 (EN), X1.1
/AUX1: CON3.1, R15.2, U1.12 (PIN)
/BUZZER: R14.2, T2.1 (G), U7.19
/CPLD_OE: CON3.8, U7.43
/CTS_A: CON1.6, U7.24
/CTS_B: CON4.9, U7.60
/CTS_C: CON3.5, U2.41 (CTS_C)
/CTS_D: CON4.14, U2.54 (CTS_D)
/D+: R4.2, U2.8 (DP)
/D-: R2.2, U2.7 (DM)
/DCD_D: CON4.13, U2.58 (DCD_D)
/DSR_D: CON4.12, U2.57 (DSR_D)
/DTR_A: CON3.9, U7.45
/DTR_B: CON3.6, U7.42
/DTR_C: CON1.7, U2.43 (DTR_C)
/DTR_D: CON4.15, U2.55 (DTR_D)
/EECLK: CON4.21, R8.1, U2.62 (EECLK), U6.4 (CLK)
/EECS: CON4.22, R10.1, U2.63 (EECS), U6.5 (CS)
/EEDATA: CON4.20, R11.1, U2.61 (EEDATA), U6.3 (DI)
/FTDI_CTS_A: U2.19 (CTS_A), U7.11
/FTDI_CTS_B: U2.29 (CTS_B), U7.6
/FTDI_DTR_A: U2.21 (DTR_A), U7.10
/FTDI_DTR_B: U2.30 (DTR_B), U7.5 (P5/GTS1)
/FTDI_RESET: CON3.10, R12.1, U2.14 (RESET#)
/FTDI_RTS_A: U2.18 (RTS_A), U7.15 (P15/GCK1)
/FTDI_RTS_B: U2.28 (RTS_B), U7.7
/FTDI_RXD_A: U2.17 (RXD_A), U7.16 (P16/GCK2)
/FTDI_RXD_B: U2.27 (RXD_B), U7.8
/FTDI_RXD_C: U2.39 (RXD_C), U7.2 (P2/GTS2)
/FTDI_RXD_D: U2.52 (RXD_D), U7.63
/FTDI_TXD_A: U2.16 (TXD_A), U7.17 (P17/GCK3)
/FTDI_TXD_B: U2.26 (TXD_B), U7.9
/FTDI_TXD_D: U2.48 (TXD_D), U7.64 (P64/GSR)
/ISO_D+: J1.3 (D+), R3.1, U3.3 (IO2), U3.4 (IO2)
/ISO_D-: J1.2 (D-), R1.1, U3.1 (IO1), U3.6 (IO1)
/OPTO_EN: R13.2, T1.1 (G), U7.20
/RI_D: CON4.11, U2.59 (RI/TXDEN_D)
/RTS_D: CON4.16, U2.53 (RTS_D)
/RXD_A: CON1.4, U7.25
/RXD_B: CON4.4, U7.48
/RXD_C: CON3.7, U7.44
/RXD_D: CON4.17, U7.61
/SR_CLK: CON4.6, U7.38
/SR_DATA: CON4.5, U7.50
/SR_LOAD: CON4.1, U7.39
/TCK: CON5.3, U7.30 (TCK)
/TDI: CON5.5, U7.28 (TDI)
/TDO: CON5.4, U7.53 (TDO)
/TMS: CON5.6, U7.29 (TMS)
/TXD_A: CON1.8, U7.35
/TXD_B: CON4.8, U7.56
/TXD_C: CON1.5, U2.38 (TXD_C), U7.33
/TXD_D: CON4.19, U7.62
/VPHY: C9.1, C11.1, R7.2, U2.4 (VPHY)
/VPLL: C8.1, C10.1, R6.2, U2.9 (VPLL)
/~CTS_A_OC: CON1.3, U7.27
/~CTS_B_OC: CON4.7, U7.57
/~PWREN: CON4.18, U2.60 (PWREN#)
/~RXD_A_OC: CON3.3, U7.36
/~RXD_B_OC: CON4.3, U7.49
/~USB_SUSPEND: CON4.2, U2.36 (SUSPEND#)
GND: C4.2, C5.2, C6.2, C7.2, C8.2, C9.2, C10.2, C11.2, C12.2, C13.2, C14.2, C15.2, C16.2, C17.2, C18.2, C19.2, C20.2, C21.2, C22.2, C23.2, C24.2, C25.2, C26.2, C27.2, C28.2, C29.2, CON1.1, CON1.2, CON2.3, CON2.4, CON4.23, CON4.24, CON5.2, Q1.2, Q1.4, R5.1, R13.1, R14.1, R15.1, REL1.COM, T1.2 (S), T2.2 (S), TP1.1, TP4.1, U1.9 (GND2), U1.15 (GND2), U2.1 (GND), U2.5 (GND), U2.10 (AGND), U2.11 (GND), U2.13 (TEST), U2.15 (GND), U2.25 (GND), U2.35 (GND), U2.47 (GND), U2.51 (GND), U4.3 (GND-OUT), U5.2 (GND), U6.2 (GND), U7.21 (GND), U7.41 (GND), U7.54 (GND)
ISO_GND: C1.2, C2.2, C3.2, J1.4 (GND), J1.5 (Shield), REL1.NO, U1.2 (GND1), U1.8 (GND1), U3.2 (GND), U4.1 (GND-IN)
ISO_VDD: C1.1, C2.1, J1.1 (VBUS), U1.1 (VBUS1), U3.5 (VBUS), U4.2 (VCC-IN)
unnamed: C3.1, U1.3 (VDD1), U1.4 (PDEN), U1.5 (SPU)
unnamed: C4.1, U1.13 (SPD), U1.14 (VDD2)
unnamed: C6.1, Q1.1, U2.2 (OSCI)
unnamed: C7.1, Q1.3, U2.3 (OSCO)
unnamed: D1.1 (C), REL1.C2 (COIL2), T1.3 (D)
unnamed: D2.1 (C), T2.3 (D), X1.2
unnamed: R1.2, U1.6 (UD-)
unnamed: R2.1, U1.11 (DD-)
unnamed: R3.2, U1.7 (UD+)
unnamed: R4.1, U1.10 (DD+)
unnamed: R5.2, U2.6 (REF)
unnamed: R9.1, R11.2, U6.1 (DO)
unnamed: TP5.1, U7.22

Notes on the sheet:
SPY mode
RxD D TxD D
RxD B TxD B
RxD C TxD C
RxD D
TxD D
normal mode
SPI mode
TxD
RxD
RTS
CTS
DTR
SCK
MISO
MOSI
I2C mode
SDA
SCL
UART mode
TxD B
TxD C
FTDI PIN RxD TxD CTS RTS
Function MOSI SCK CS MISO
Opto channel DTR TxD RTS CTS
Output pin RxD TxD RTS CTS
SPI connections
FTDI PIN RxD TxD RTS
Function SDA_OUT SCL SDA_IN
Opto channel DTR TxD CTS
Output pin CTS TxD CTS
I2C connections

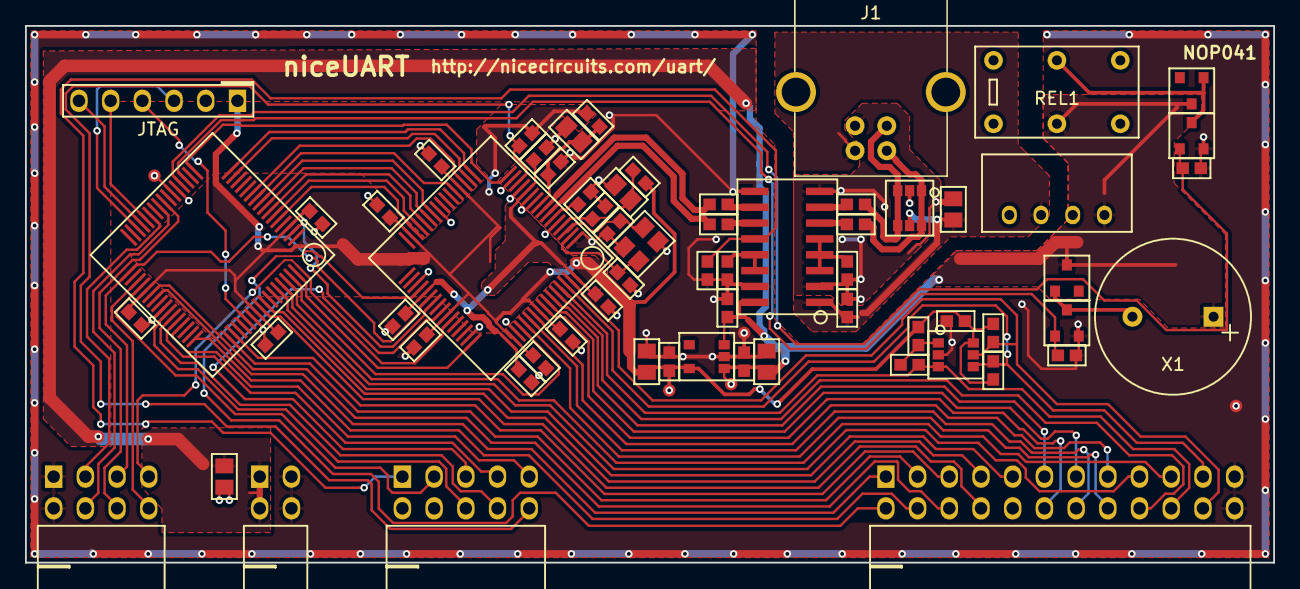
[picture p22: board SUPER_UART_main.kicad_pcb from above]

Board: 2 copper layers, 100.0 x 43.0 mm, 71 parts (1 on the bottom side), 79 nets.
