NiceCircuits/SUPER_UART/stm32/super_uart/super_uart.ioc

Mcu.UserName=STM32F030R8Tx
PA0.GPIO_Label=N_VDD1_EN
PA0.Signal=GPIO_Output
PA1.GPIO_Label=SW3
PA1.Signal=GPIO_Input
PA10.GPIO_Label=RXD
PA10.Signal=GPIO_Input
PA11.GPIO_Label=VDD1_SEL1
PA11.Signal=S_TIM1_CH4
PA12.GPIO_Label=SW4
PA12.Signal=GPIO_Input
PA13.Signal=SYS_SWDIO
PA14.Signal=SYS_SWCLK
PA2.GPIO_Label=N_FTDI_RESET
PA2.Signal=GPIO_Output
PA6.GPIO_Label=LED1
PA6.Signal=GPIO_Output
PA7.GPIO_Label=LED2
PA7.Signal=GPIO_Output
PA8.GPIO_Label=LED5
PA8.Signal=GPIO_Output
PA9.GPIO_Label=TXD
PA9.Signal=GPIO_Output
PB0.GPIO_Label=LED3
PB0.Signal=GPIO_Output
PB1.GPIO_Label=LED4
PB1.Signal=GPIO_Output
PB10.GPIO_Label=N_ENUMERATE
PB10.Signal=GPIO_Output
PB12.GPIO_Label=SR_LOAD
PB12.Signal=GPIO_Output
PB13.GPIO_Label=SR_CLK
PB13.Signal=SPI2_SCK
PB15.GPIO_Label=SR_DATA
PB15.Signal=SPI2_MOSI
PB3.GPIO_Label=VDD2_SEL2
PB3.Signal=GPIO_Output
PB4.GPIO_Label=VDD2_SEL1
PB4.Signal=S_TIM3_CH1
PB5.GPIO_Label=SPI_EN_A
PB5.Signal=GPIO_Output
PB6.GPIO_Label=N_VDD2_EN
PB6.Signal=GPIO_Output
PB7.GPIO_Label=N_VDD2_ERR
PB7.Signal=GPIO_Input
PB8.GPIO_Label=COL1
PB8.Signal=GPIO_Output
PC0.GPIO_Label=SW2
PC0.Signal=GPIO_Input
PC1.GPIO_Label=CPLD_OE
PC1.Signal=GPIO_Output
PC12.GPIO_Label=VDD2_SEL3
PC12.Signal=GPIO_Output
PC13.GPIO_Label=N_PWREN
PC13.Signal=GPIO_Input
PC15-OSC32_OUT.GPIO_Label=COL2
PC15-OSC32_OUT.Signal=GPIO_Output
PC2.GPIO_Label=SPI_EN_B
PC2.Signal=GPIO_Output
PC3.GPIO_Label=N_USB_SUSPEND
PC3.Signal=GPIO_Input
PC4.GPIO_Label=SW1
PC4.Signal=GPIO_Input
PC7.GPIO_Label=COL3
PC7.Signal=GPIO_Output
PC8.GPIO_Label=COL4
PC8.Signal=GPIO_Output
PC9.GPIO_Label=N_I2C_PU_EN_A
PC9.Signal=GPIO_Output
PF0-OSC_IN.GPIO_Label=N_I2C_PU_EN_B
PF0-OSC_IN.Signal=GPIO_Output
PF1-OSC_OUT.GPIO_Label=N_VDD1_ERR
PF1-OSC_OUT.Signal=GPIO_Input
PF6.GPIO_Label=VDD1_SEL2
PF6.Signal=GPIO_Output
PF7.GPIO_Label=VDD1_SEL3
PF7.Signal=GPIO_Output
