NiceCircuits/SUPER_UART/(commit log)

2017-06-03 Working on schematic
    [SUPER_UART_front.kicad_pcb, SUPER_UART_front.sch, SUPER_UART_front_RS232.sch, SUPER_UART_front_UART1.sch, SUPER_UART_front_UART234.sch, SUPER_UART_front_uC.sch]
2017-06-18 PCB placement
    [SUPER_UART_front.kicad_pcb, SUPER_UART_front.sch, SUPER_UART_front_RS232.sch, SUPER_UART_front_UART1.sch, SUPER_UART_front_UART234.sch, SUPER_UART_front_uC.sch]
2017-07-09 Routing before moving to 4 layers
    [SUPER_UART_front.kicad_pcb, SUPER_UART_front.sch, SUPER_UART_front_RS232.sch, SUPER_UART_front_UART1.sch, SUPER_UART_front_UART234.sch, SUPER_UART_front_uC.sch, SUPER_UART_main.sch]
2017-07-15 Front board routed
    [SUPER_UART_front.kicad_pcb, SUPER_UART_front_RS232.sch, SUPER_UART_front_UART1.sch, SUPER_UART_front_UART234.sch, SUPER_UART_front_uC.sch]
2017-07-15 Silkscreen and 3D model updated
    [SUPER_UART_front.kicad_pcb]
2017-10-21 Add CPLD project
    [SUPER_UART.sch]
2017-11-04 STM32 firmware - initial commit
    [.custom.cfg, super_uart Debug.cfg, super_uart.cfg]
2020-11-18 Add missing files
    [SUPER_UART.sch, SUPER_UART.xlsx, SUPER_UART_BOM.xlsx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]
