NiceCircuits/SUPER_UART/(notices)

Notices in the files:
stm32/super_uart/Src/main.c:
(C) COPYRIGHT STMicroelectronics *****END OF FILE
